OpenRetroPad/OpenRetroPadHW/ATmega32u4/outputs/OpenRetroPad-top.png

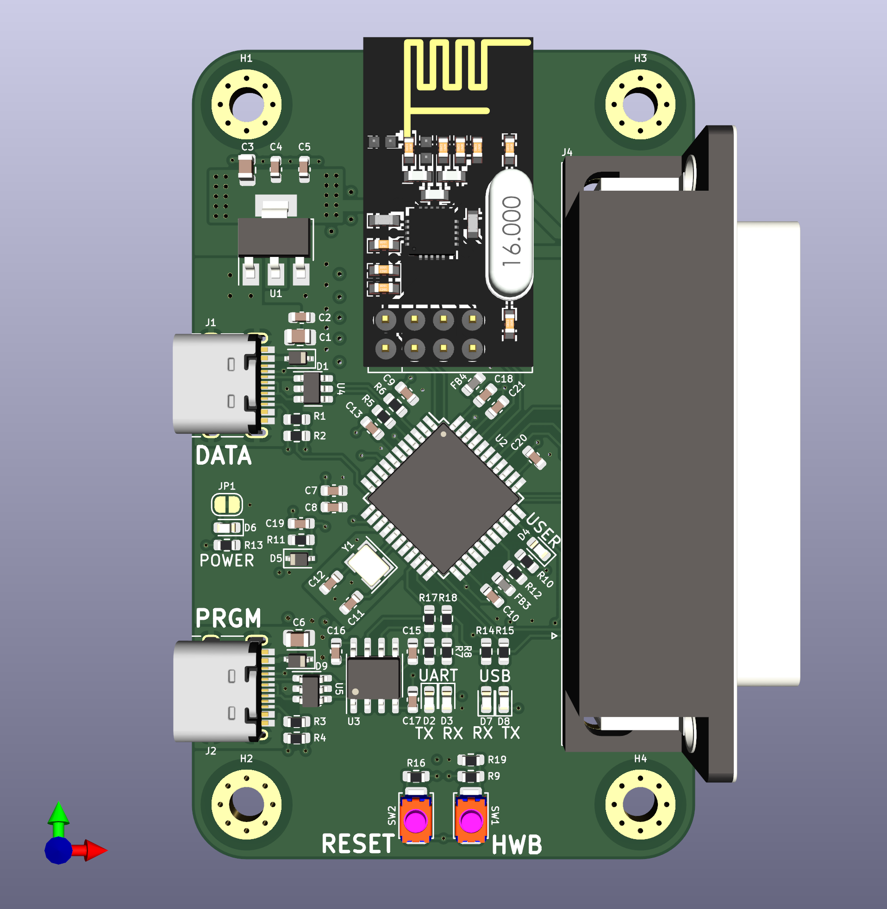
ATmega32u4/outputs/OpenRetroPad-top.png
