OpenRetroPad/OpenRetroPadHW/ATmega32u4/outputs/OpenRetroPad-bottom.png

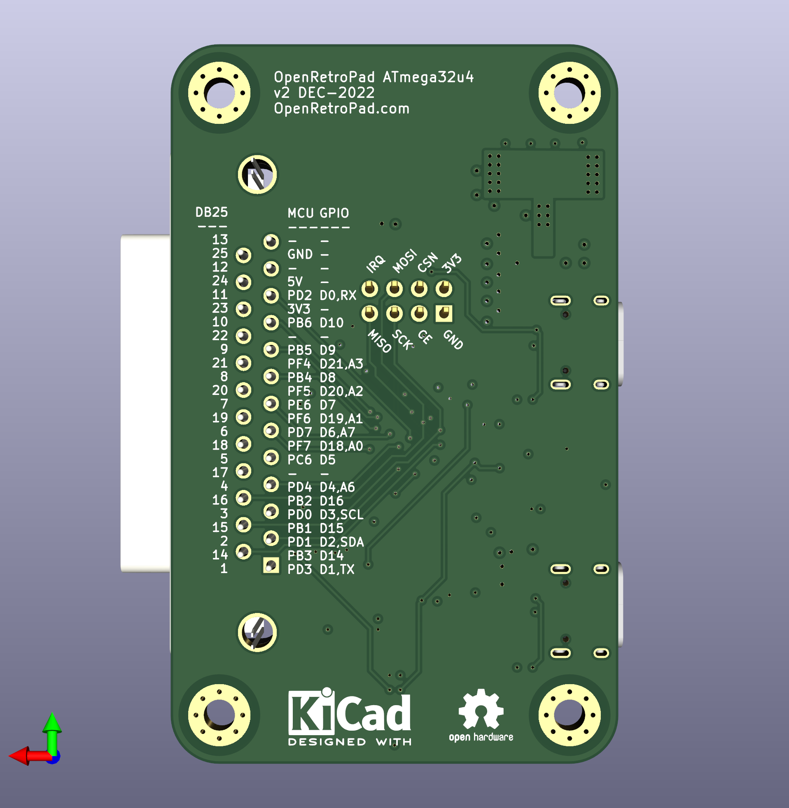
ATmega32u4/outputs/OpenRetroPad-bottom.png
