OpenRetroPad/OpenRetroPadHW/readme.md

OpenRetroPad Hardware
=====================

This repository holds some hardware designs to support [OpenRetroPad](https://github.com/OpenRetroPad/OpenRetroPad) software development. For more information, see specific hardware directories.

* [ATmega32u4](ATmega32u4)
