OpenRetroPad/OpenRetroPadHW/ATmega32u4/outputs/png/OpenRetroPad.pdf-1.png

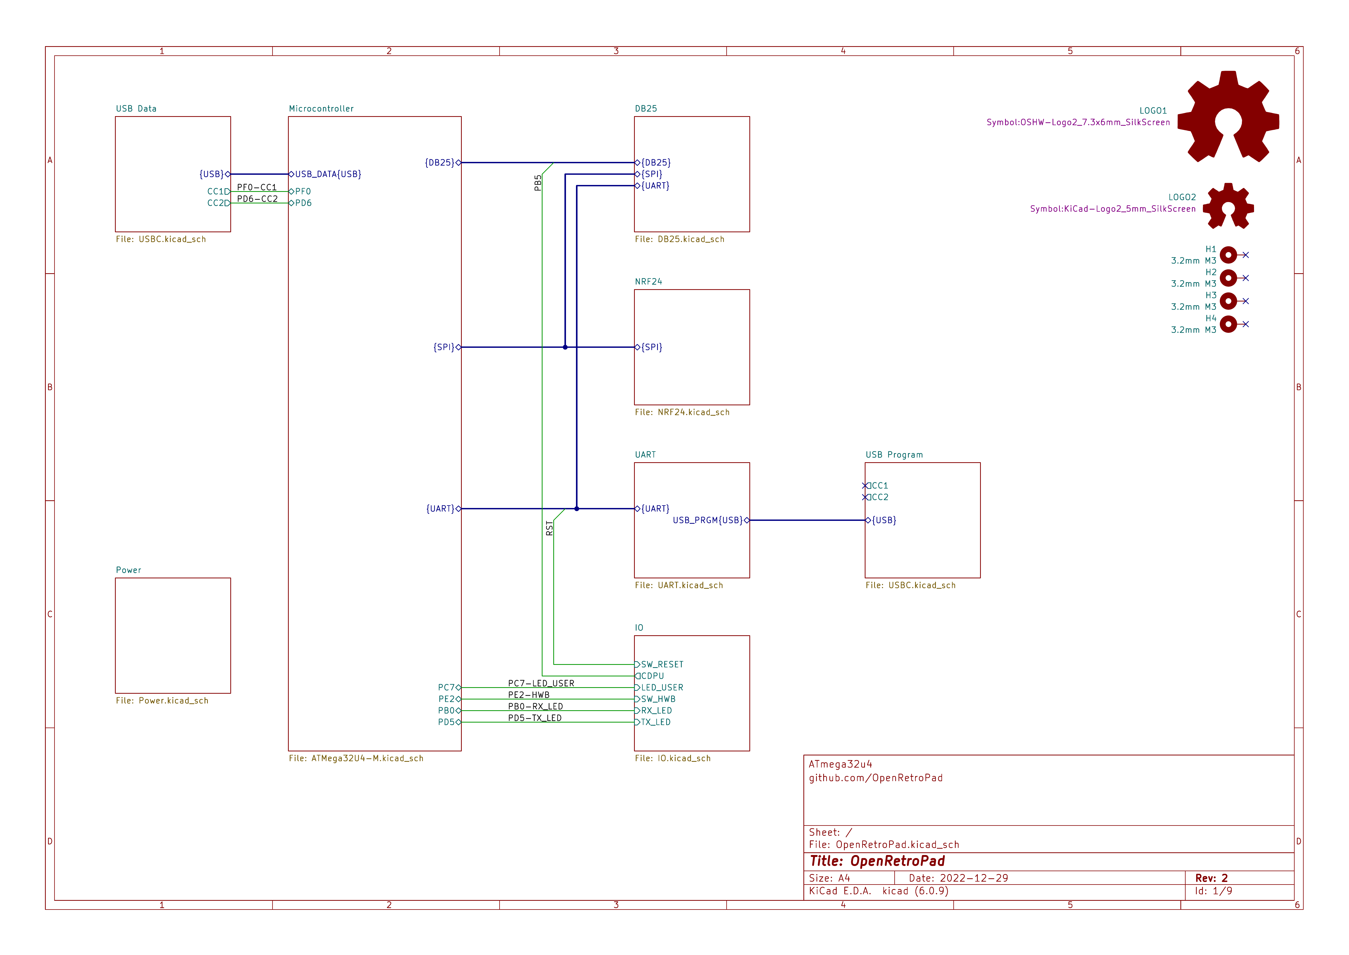
ATmega32u4/outputs/png/OpenRetroPad.pdf-1.png
