OpenRetroPad/OpenRetroPadHW/ATmega32u4/outputs/png/OpenRetroPad.pdf-2.png

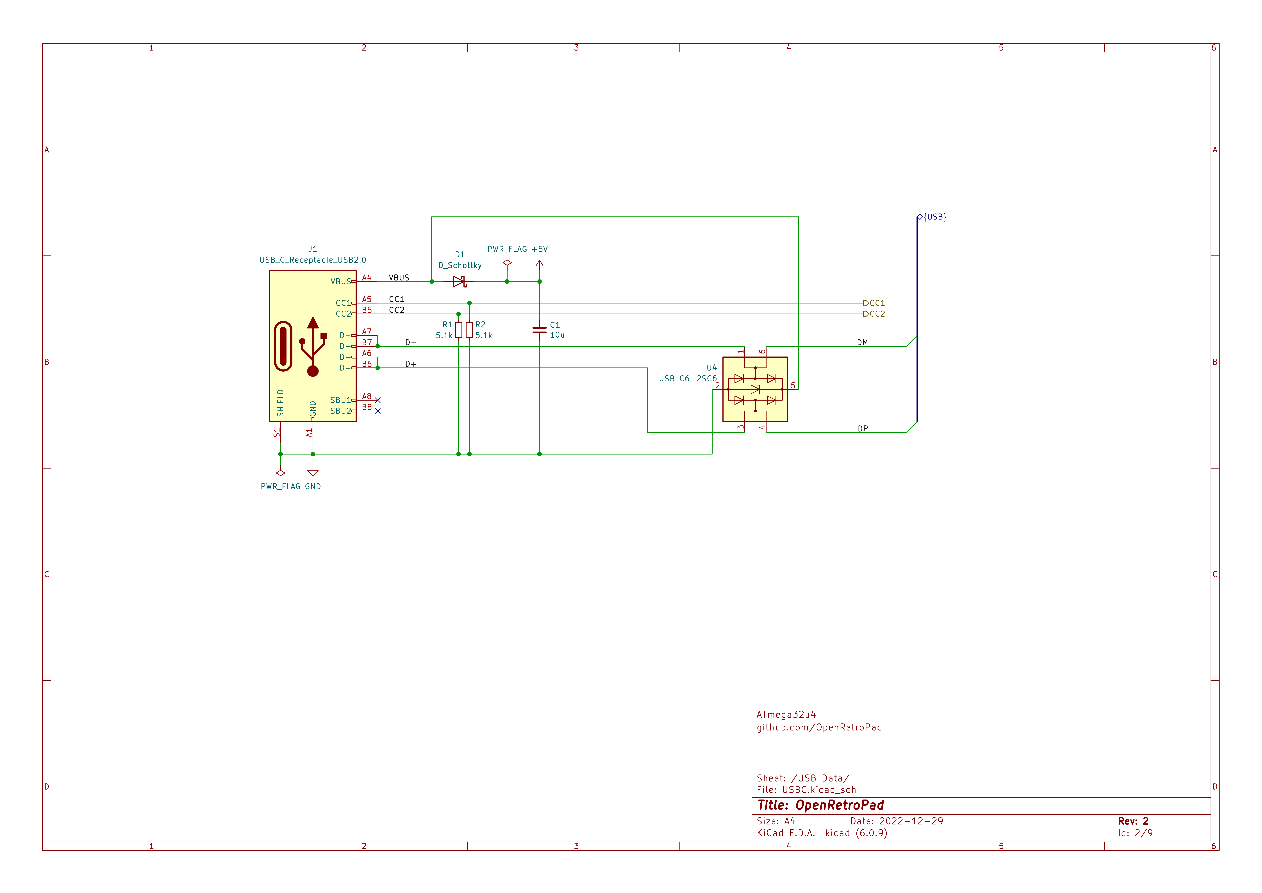
ATmega32u4/outputs/png/OpenRetroPad.pdf-2.png
