OpenRetroPad/OpenRetroPadHW/ATmega32u4/outputs/png/OpenRetroPad.pdf-3.png

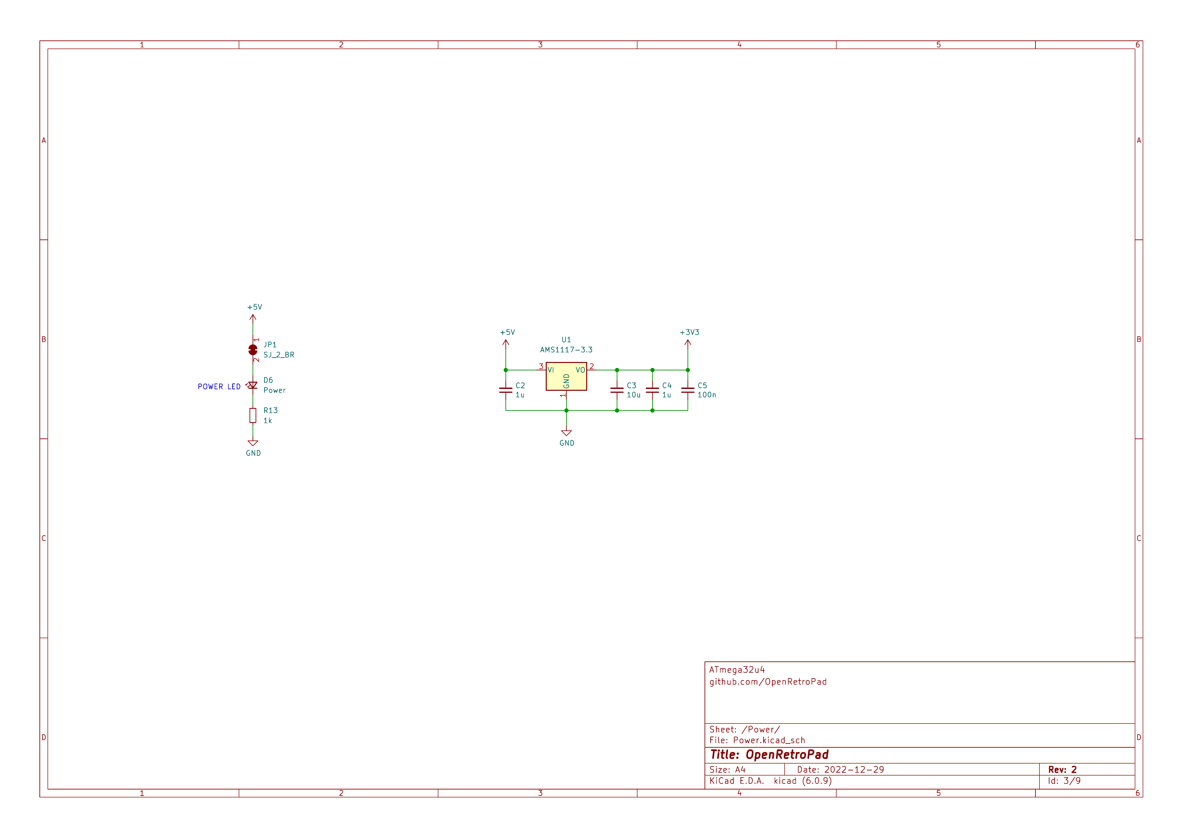
ATmega32u4/outputs/png/OpenRetroPad.pdf-3.png
