OpenRetroPad/OpenRetroPadHW/ATmega32u4/outputs/png/OpenRetroPad.pdf-5.png

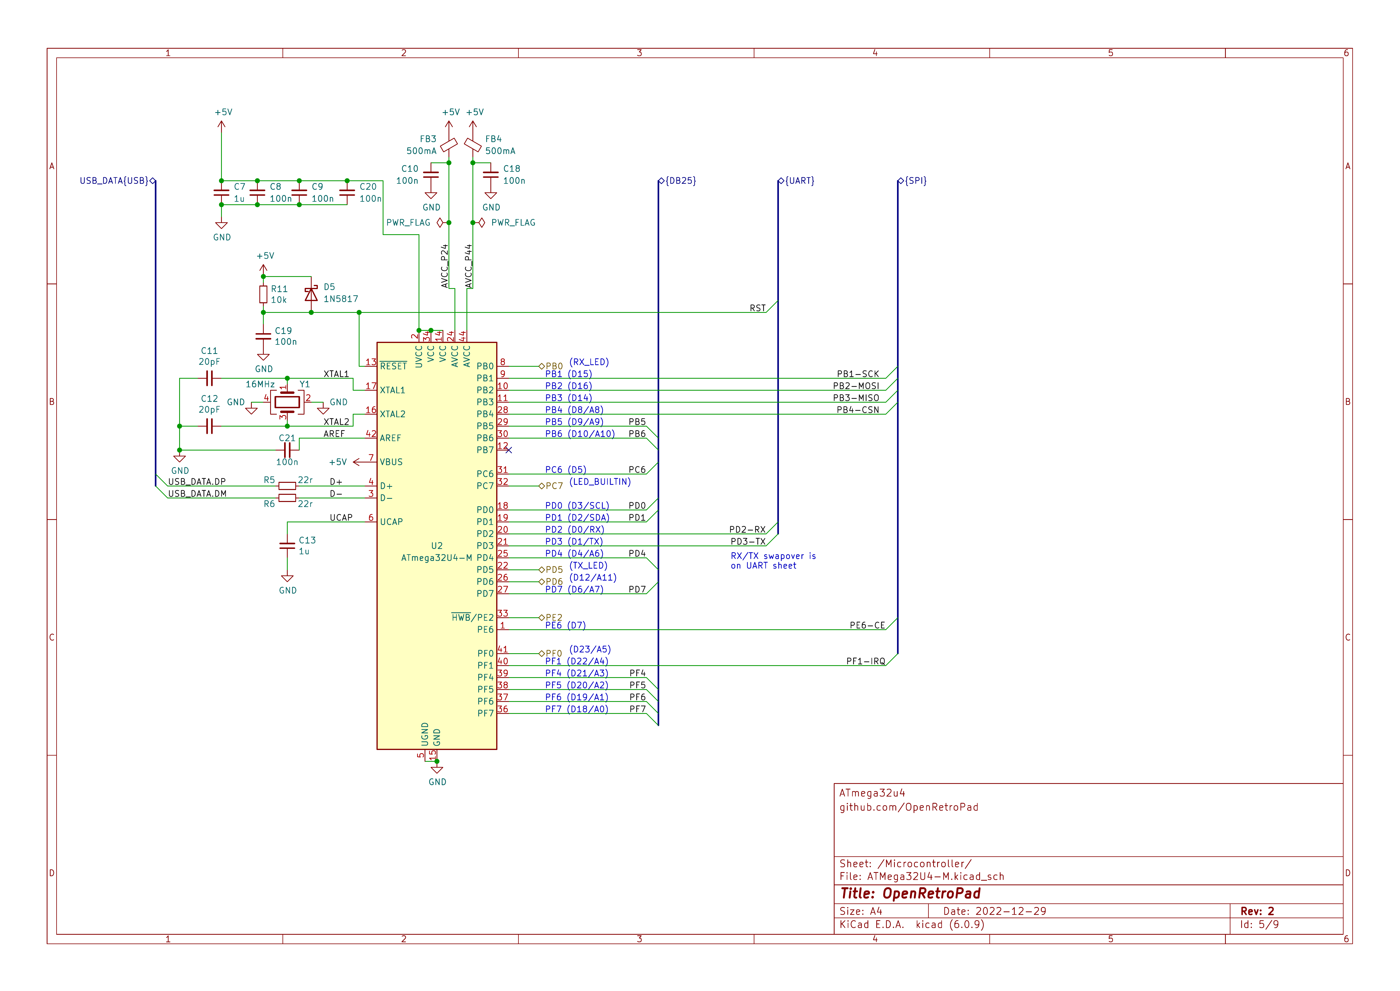
ATmega32u4/outputs/png/OpenRetroPad.pdf-5.png
