OpenRetroPad/OpenRetroPadHW/ATmega32u4/outputs/png/OpenRetroPad.pdf-6.png

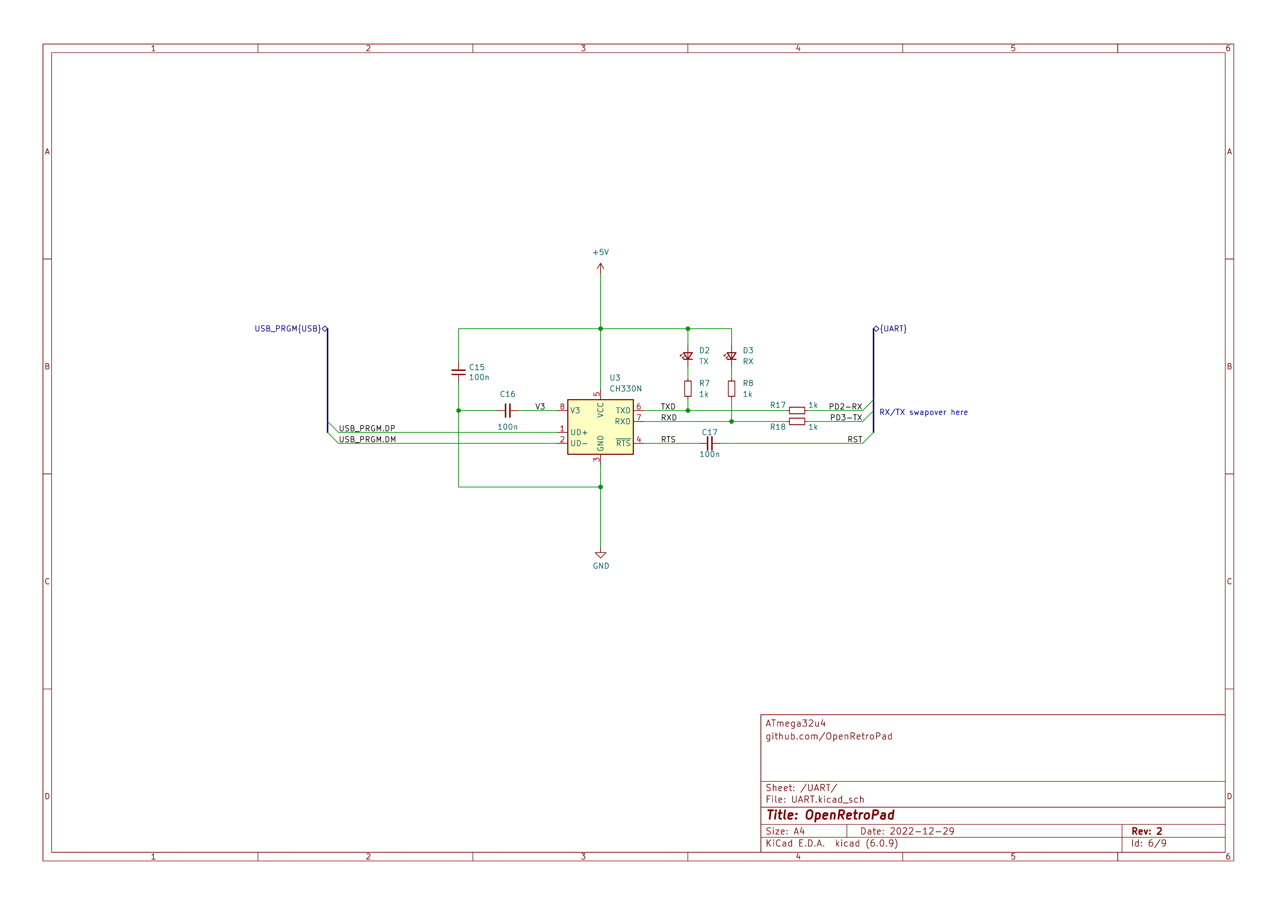
ATmega32u4/outputs/png/OpenRetroPad.pdf-6.png
