OpenRetroPad/OpenRetroPadHW/ATmega32u4/outputs/png/OpenRetroPad.pdf-7.png

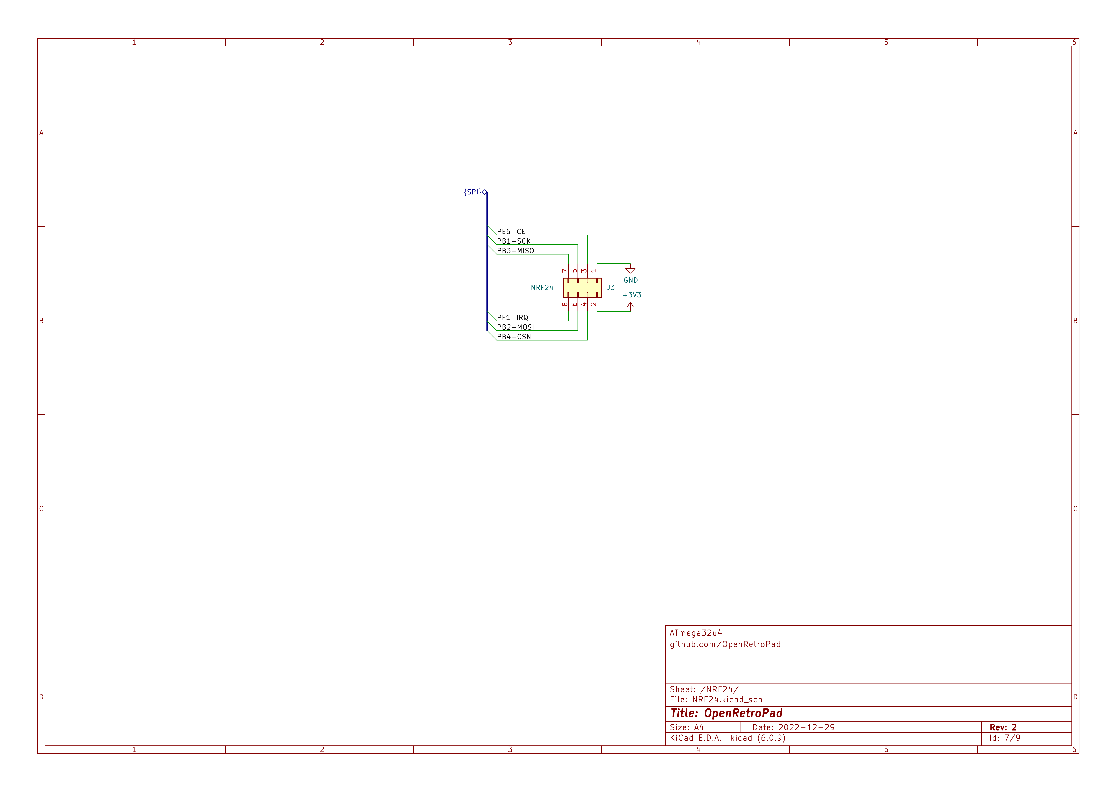
ATmega32u4/outputs/png/OpenRetroPad.pdf-7.png
