OpenRetroPad/OpenRetroPadHW/ATmega32u4/outputs/png/OpenRetroPad.pdf-8.png

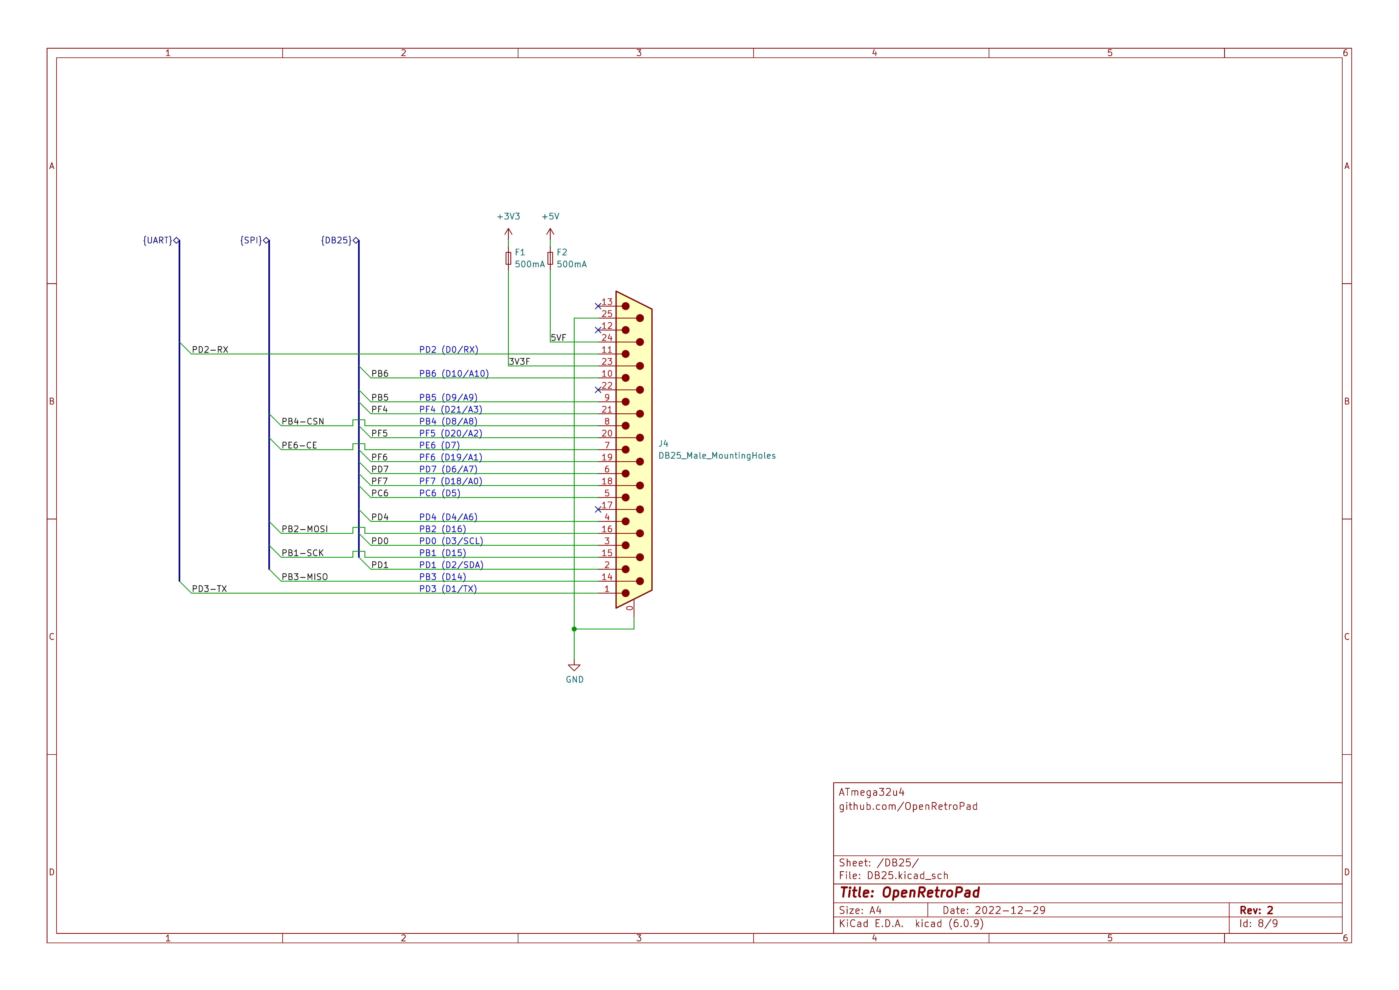
ATmega32u4/outputs/png/OpenRetroPad.pdf-8.png
