OpenRetroPad/OpenRetroPadHW/ATmega32u4/outputs/png/OpenRetroPad.pdf-9.png

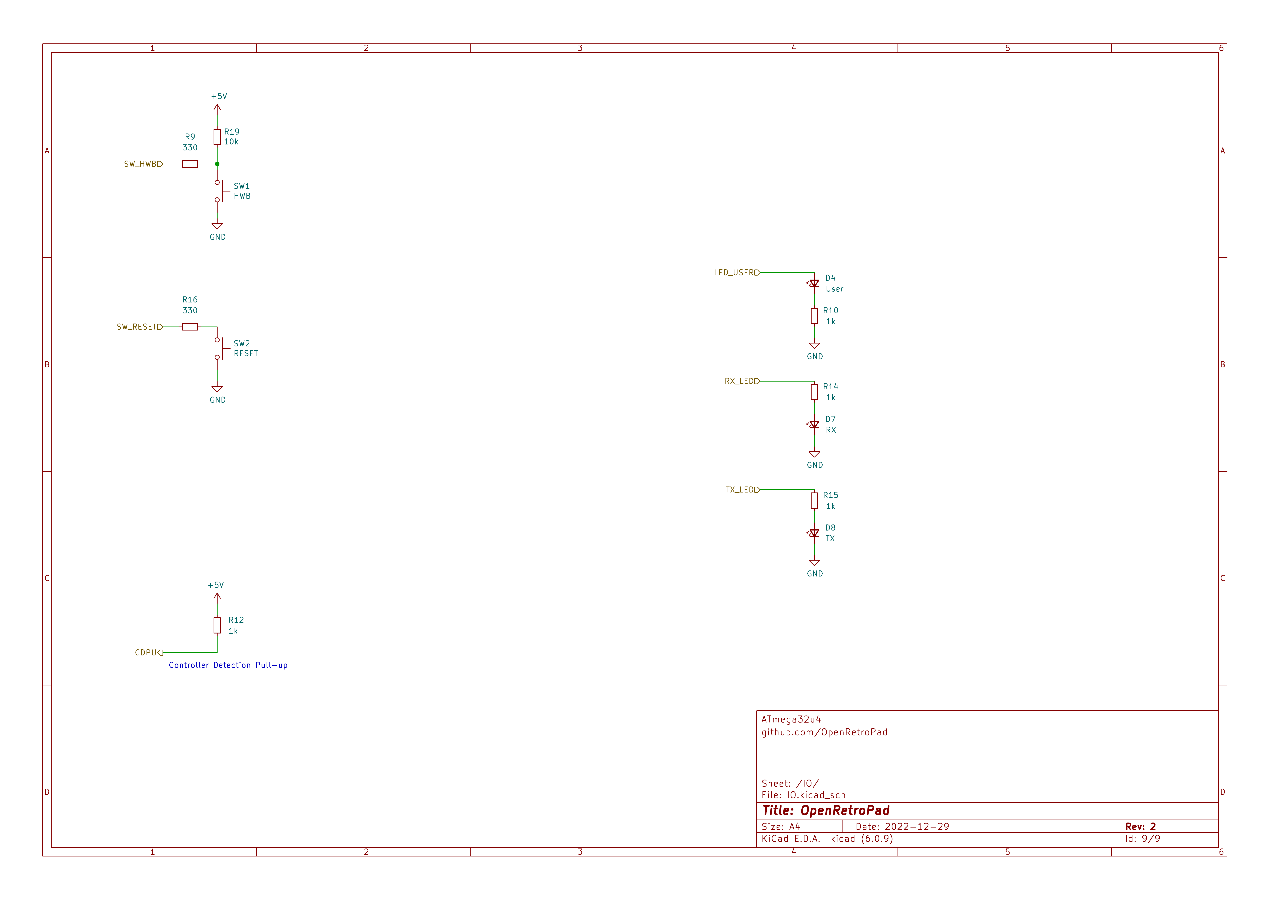
ATmega32u4/outputs/png/OpenRetroPad.pdf-9.png
