OpenRetroPad/OpenRetroPadHW/ATmega32u4/3d/SKRKAE.STEP

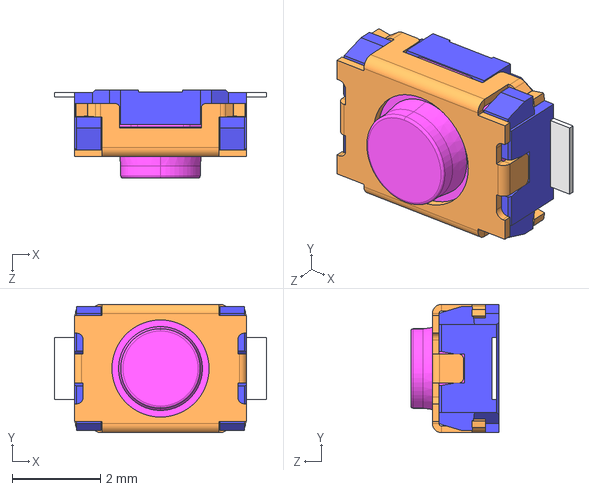
[picture p11: CAD file, 2021-01-03]
ATmega32u4/3d/SKRKAE.STEP
4.80 x 2.90 x 2.00 mm
