OpenRetroPad/OpenRetroPadHW/ATmega32u4/outputs/png/OpenRetroPad-Assembly.pdf-1.png

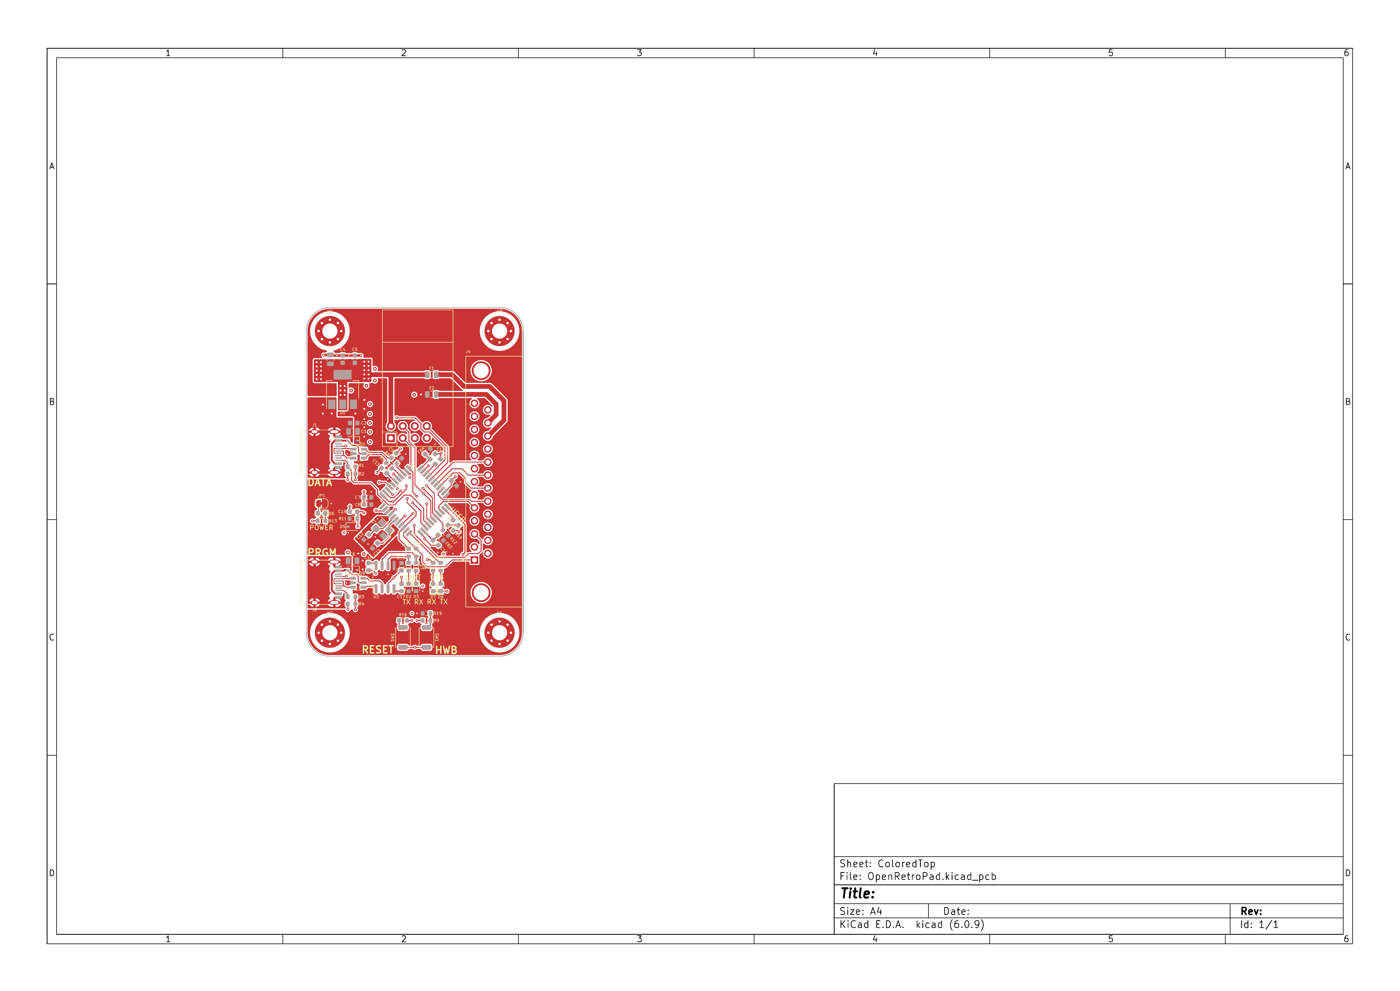
ATmega32u4/outputs/png/OpenRetroPad-Assembly.pdf-1.png
