OpenRetroPad/OpenRetroPadHW/ATmega32u4/outputs/OpenRetroPad-Assembly.pdf

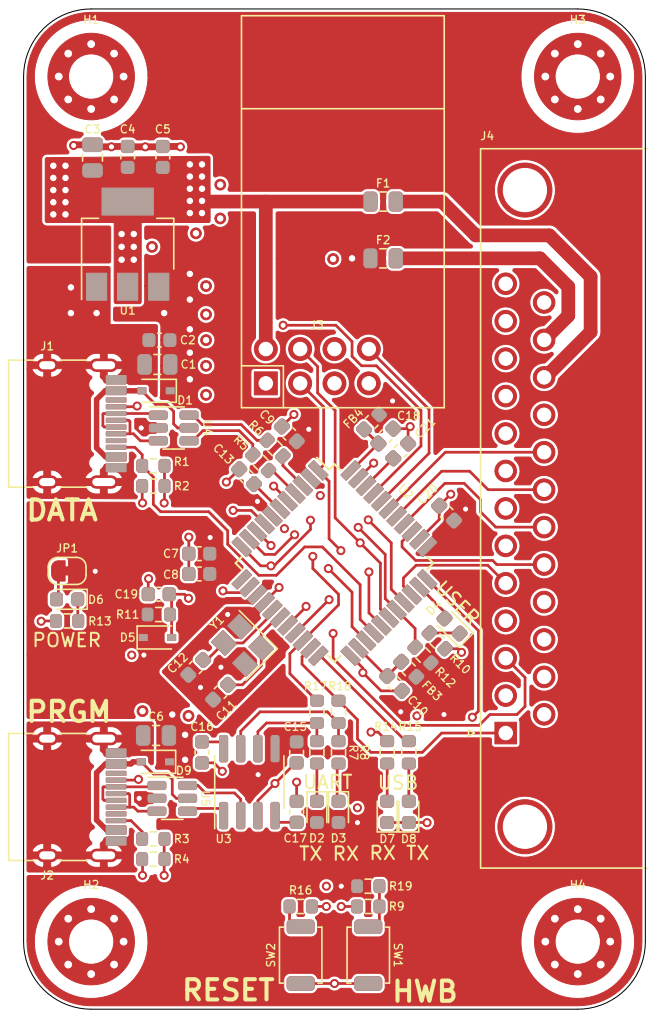
[picture p16: page 1]

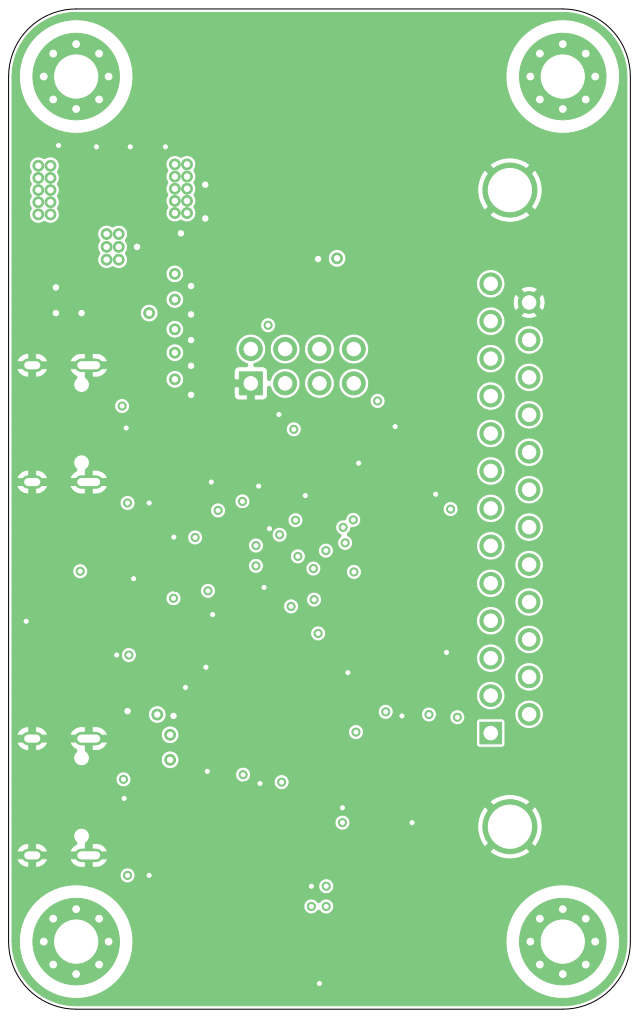
[picture p17: page 2]
D Date: KiCad E.D.A. kicad (6.0.9) Size: A4; Rev:

File: OpenRetroPad.kicad_pcb Sheet: Inner1
Id: 1/1 Title:

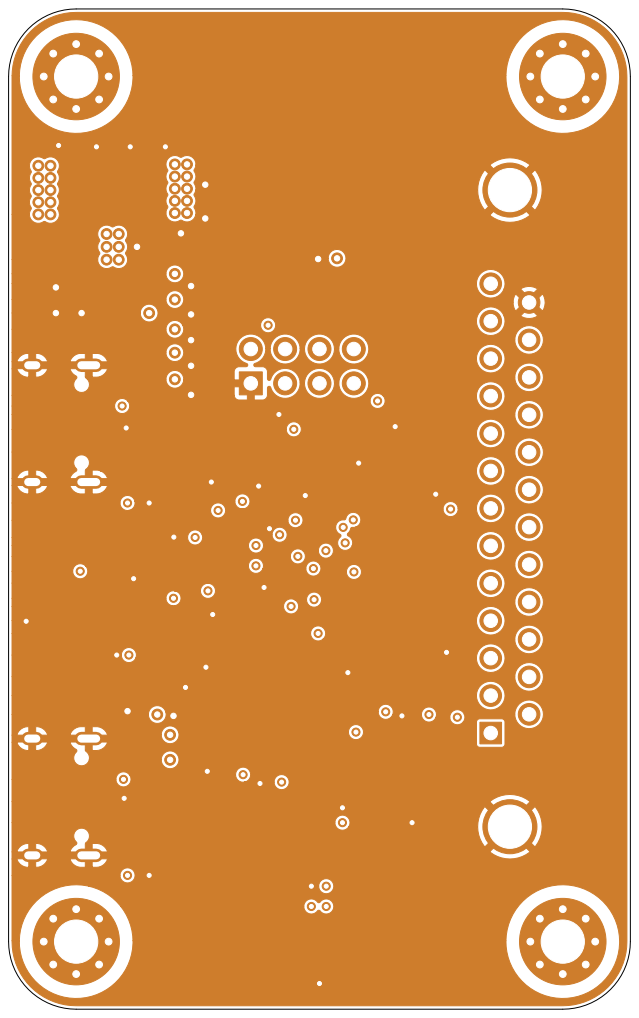
[picture p18: page 3]
D Date: KiCad E.D.A. kicad (6.0.9) Size: A4; Rev:

File: OpenRetroPad.kicad_pcb Sheet: Inner2
Id: 1/1 Title:

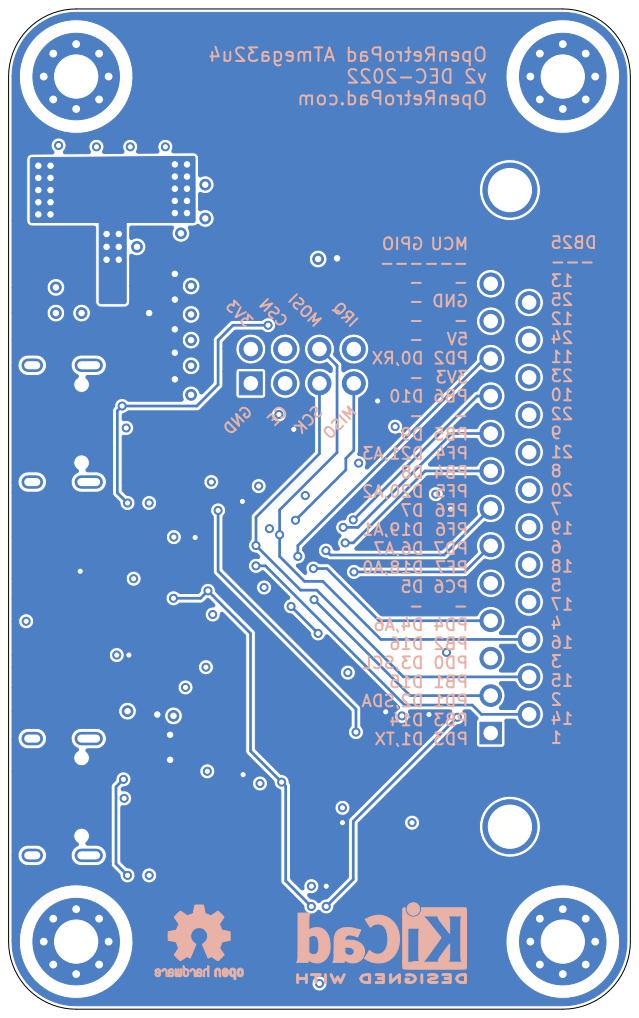
[picture p19: page 4]
141 MCU --- -GND -5V; 3V3 PB6 -PB5 PF4 PB4 PF5 PE6 PF6 PD7 PF7 PC6 -PD4 PB2 PD0 PB1 PD1 PB3 PD3 OpenRetroPad ATmega32u4; Id: 1/1 Title:

D14 D1,TX CSN 1 2 3 4 5 6 1 2 3 4 5 6 ABCD ABCD Date: KiCad E.D.A. kicad (6.0.9) Size: A4 Rev:

v2 DEC-2022 OpenRetroPad.comMOSI GND CE 3V3 GPIO

IRQ SCK MISO DB25

--- ----D0,RX -D10 -D9 D21,A3 D8 D20,A2 D7 D19,A1 D6,A7 D18,A0 D5 -D4,A6 D16 D3,SCL D15 D2,SDA

File: OpenRetroPad.kicad_pcb Sheet: ColoredBottom

36.0000 mm | 47.1000 mm | 64.0000 mm 5.0000 mm ⁵.0000 mm | 13.5000 mm

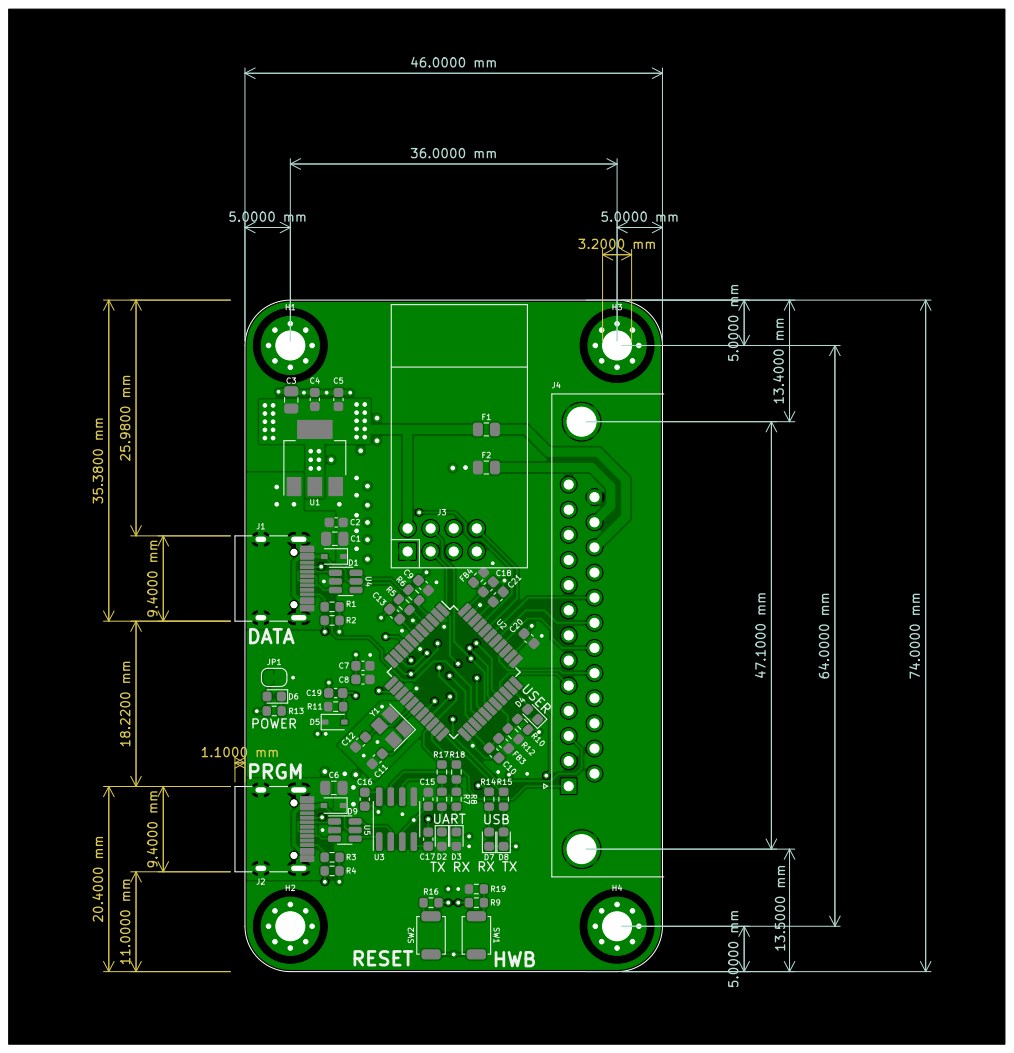
[picture p20: page 5]

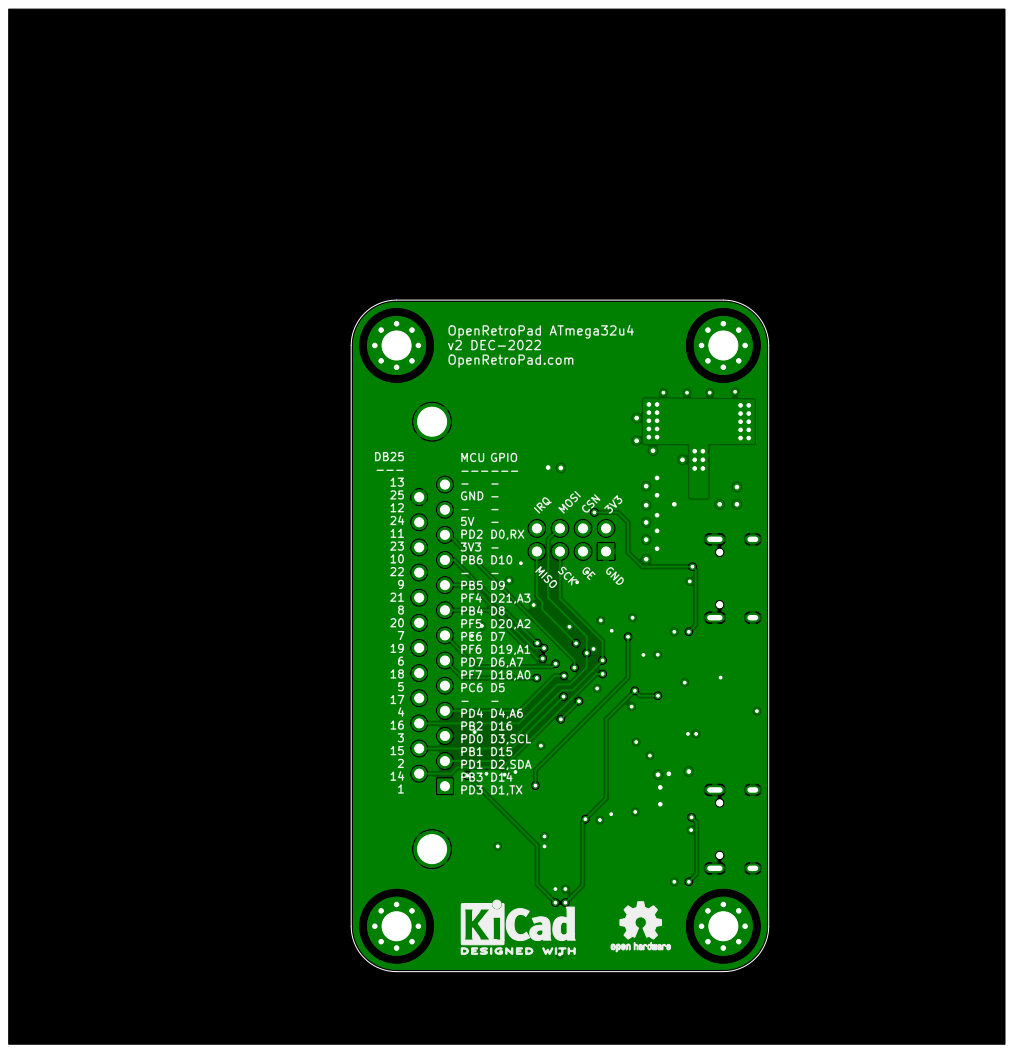
[picture p21: page 6]
6 ABCD; ABCD Date: KiCad E.D.A. kicad (6.0.9) Size: A4; Rev:; Id: 1/1 Title:; File: OpenRetroPad.kicad_pcb; CSN

3V3 PB6 -PB5 PF4 PB4 PF5 PE6 PF6 PD7 PF7 PC6 -PD4 PB2 PD0 PB1 PD1 PB3 PD3 OpenRetroPad ATmega32u4
v2 DEC-2022 OpenRetroPad.comMOSI CE GND 3V3 GPIO
Sheet: ColoredWithBlackBackgroundBottom IRQ MISOSCK DB25
141 MCU
--- -GND -5V

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
