OpenRetroPad/OpenRetroPadHW/ATmega32u4/outputs/OpenRetroPad.pdf

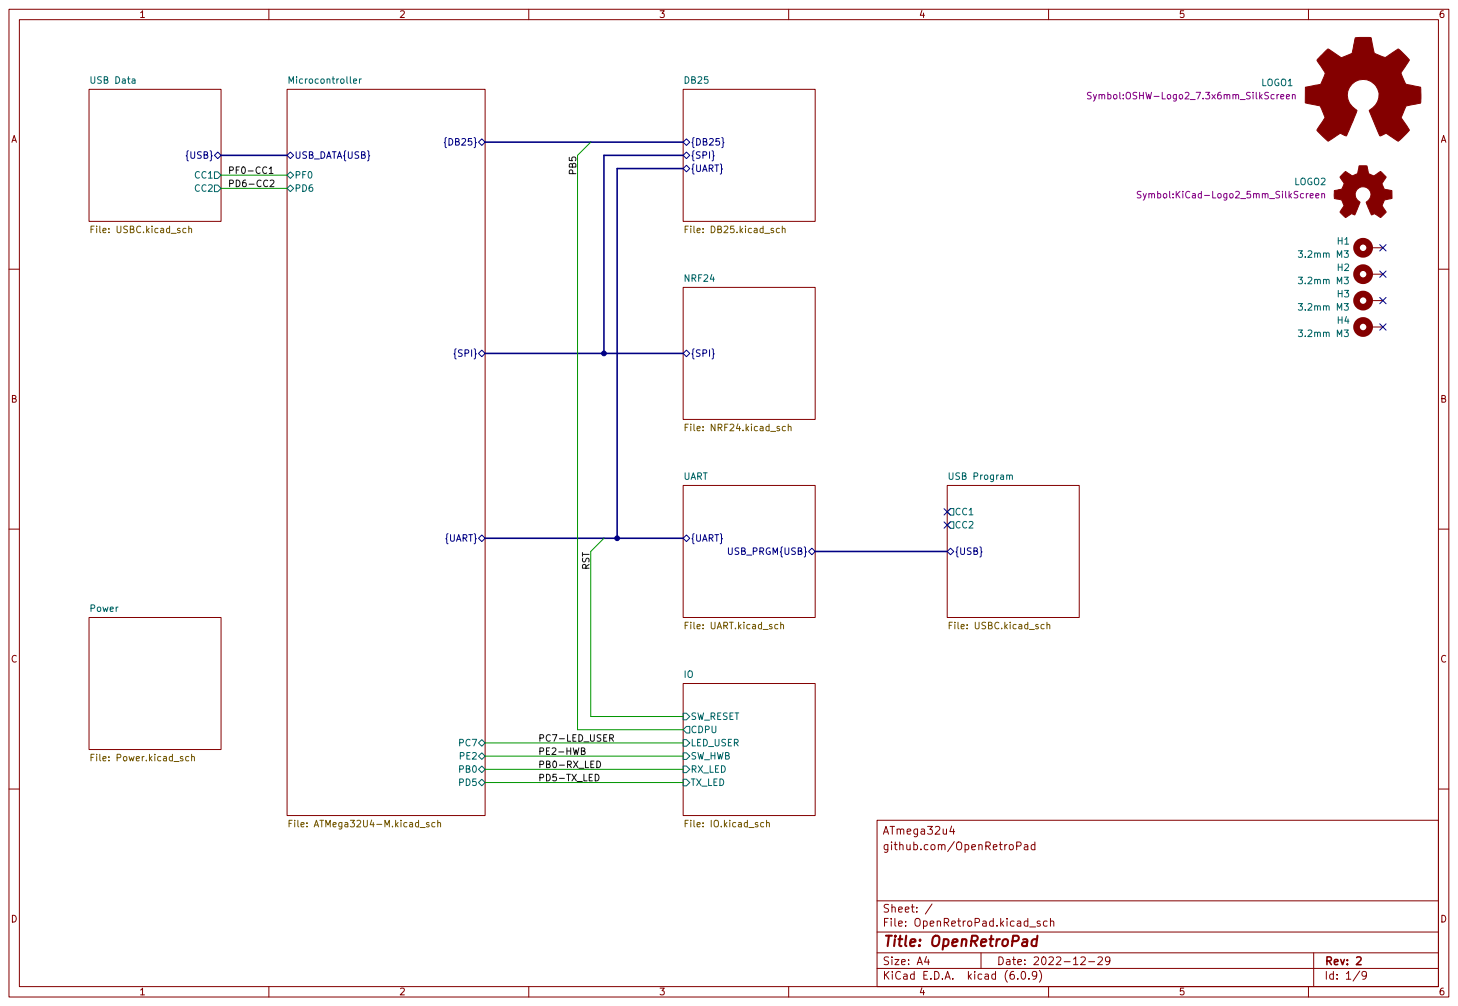
[picture p22: page 1]

{SPI} NRF24 File: NRF24.kicad_sch Power File: Power.kicad_sch

ATmega32u4
File: OpenRetroPad.kicad_sch Sheet: / github.com/OpenRetroPad

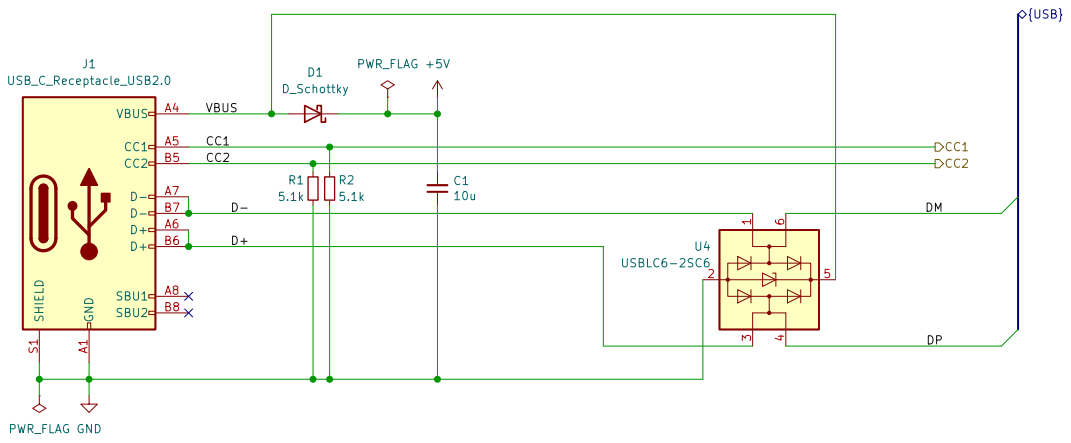
[picture p23: page 2]

ATmega32u4
File: USBC.kicad_sch Sheet: /USB Data/ github.com/OpenRetroPad

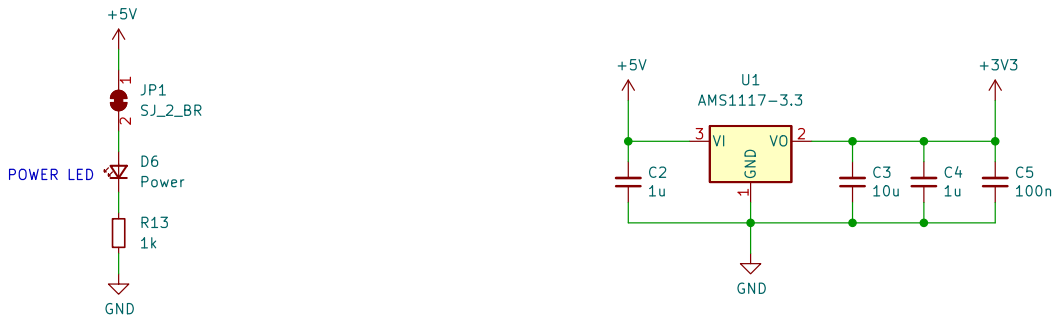
[picture p24: page 3]

File: Power.kicad_sch Sheet: /Power/ github.com/OpenRetroPad

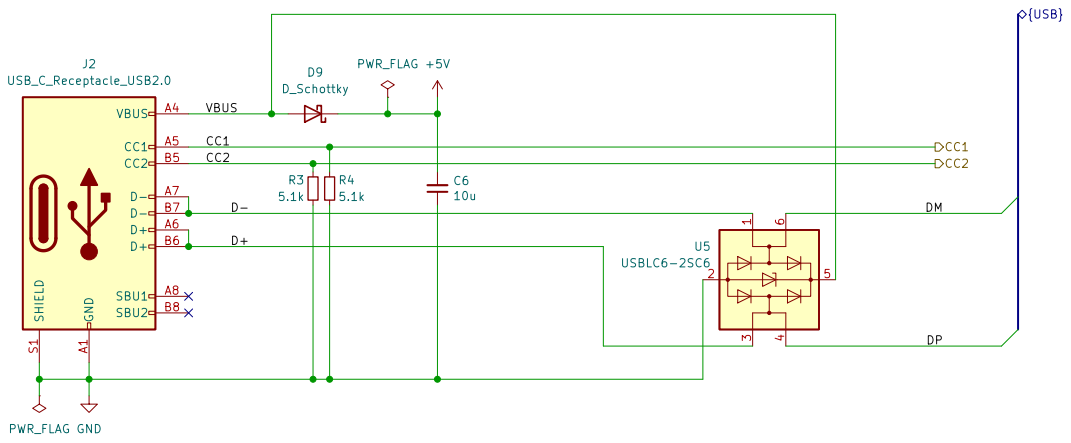
[picture p25: page 4]

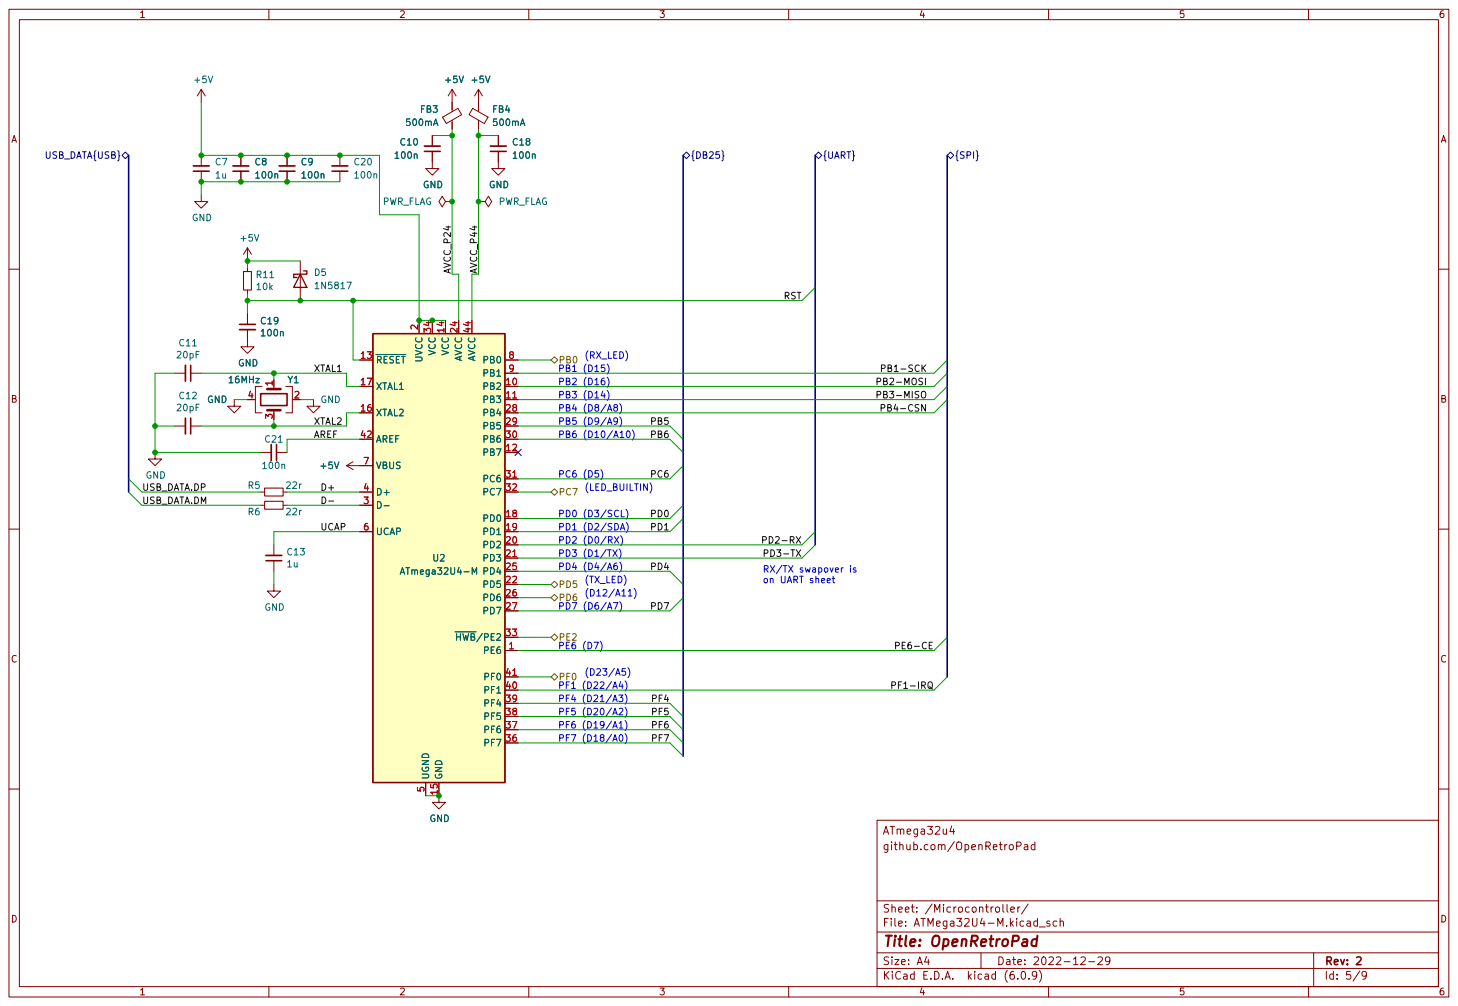
[picture p26: page 5]

2 PD2 20 PD3 21 PD5 22 AVCC 24 PD4 25 PD6 26 PD7 27 PB4 28 PB5 29 D- 3 PB6 30 PC6 31 PC7 32 ~{HWB}/PE233 VCC 34 PF7 36 PF6 37 PF5 38 PF4 39 D+ 4 PF1 40 PF0 41 AREF 42 AVCC 44 UGND

File: ATMega32U4-M.kicad_sch Sheet: /Microcontroller/ github.com/OpenRetroPad

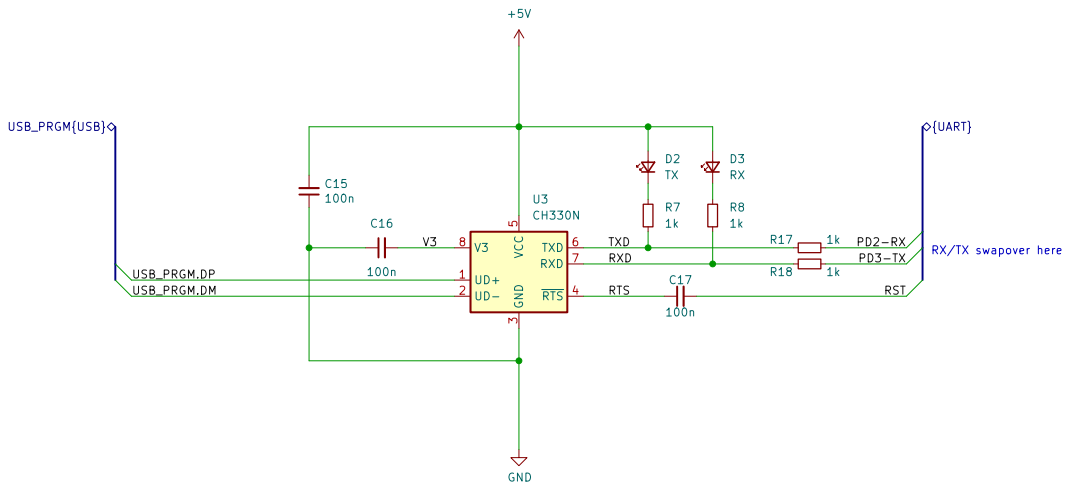
[picture p27: page 6]

File: UART.kicad_sch Sheet: /UART/ github.com/OpenRetroPad

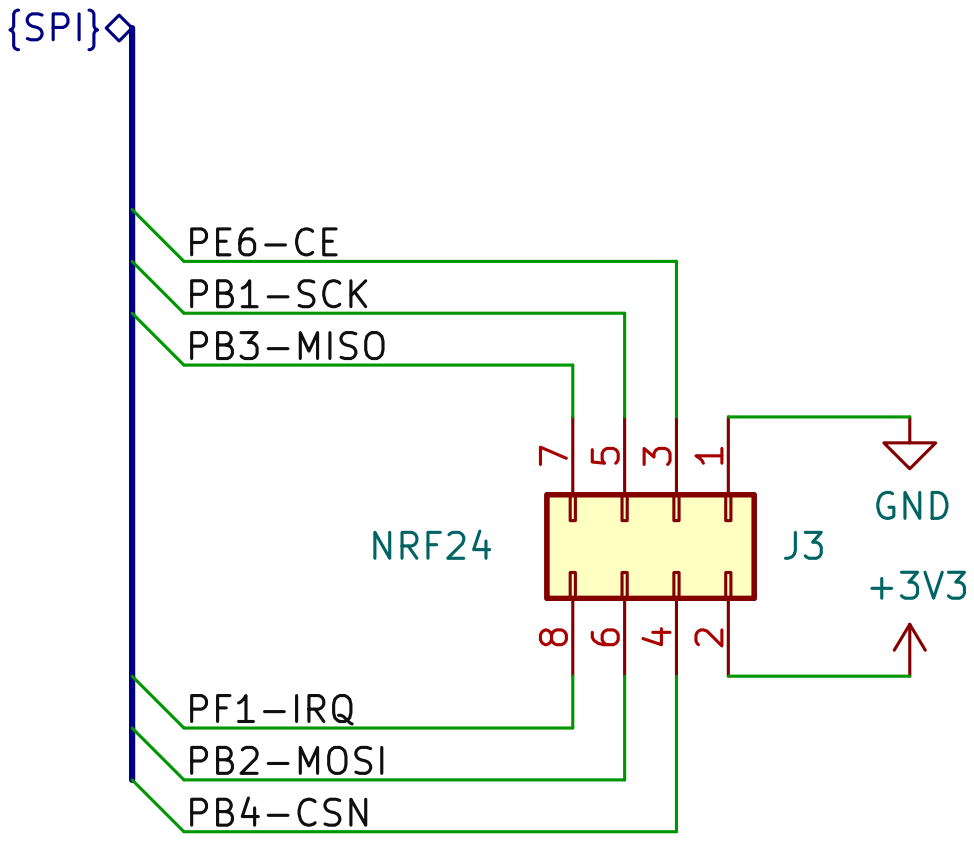
[picture p28: page 7]

File: NRF24.kicad_sch Sheet: /NRF24/ github.com/OpenRetroPad

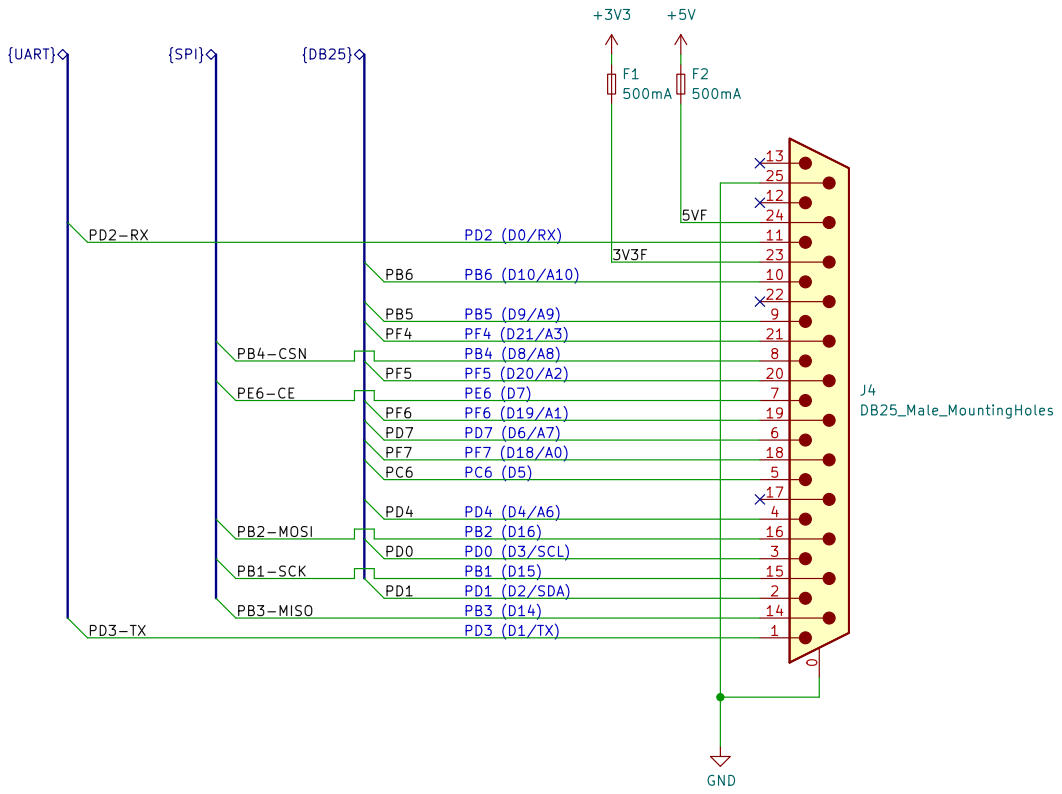
[picture p29: page 8]

ATmega32u4
File: DB25.kicad_sch Sheet: /DB25/ github.com/OpenRetroPad

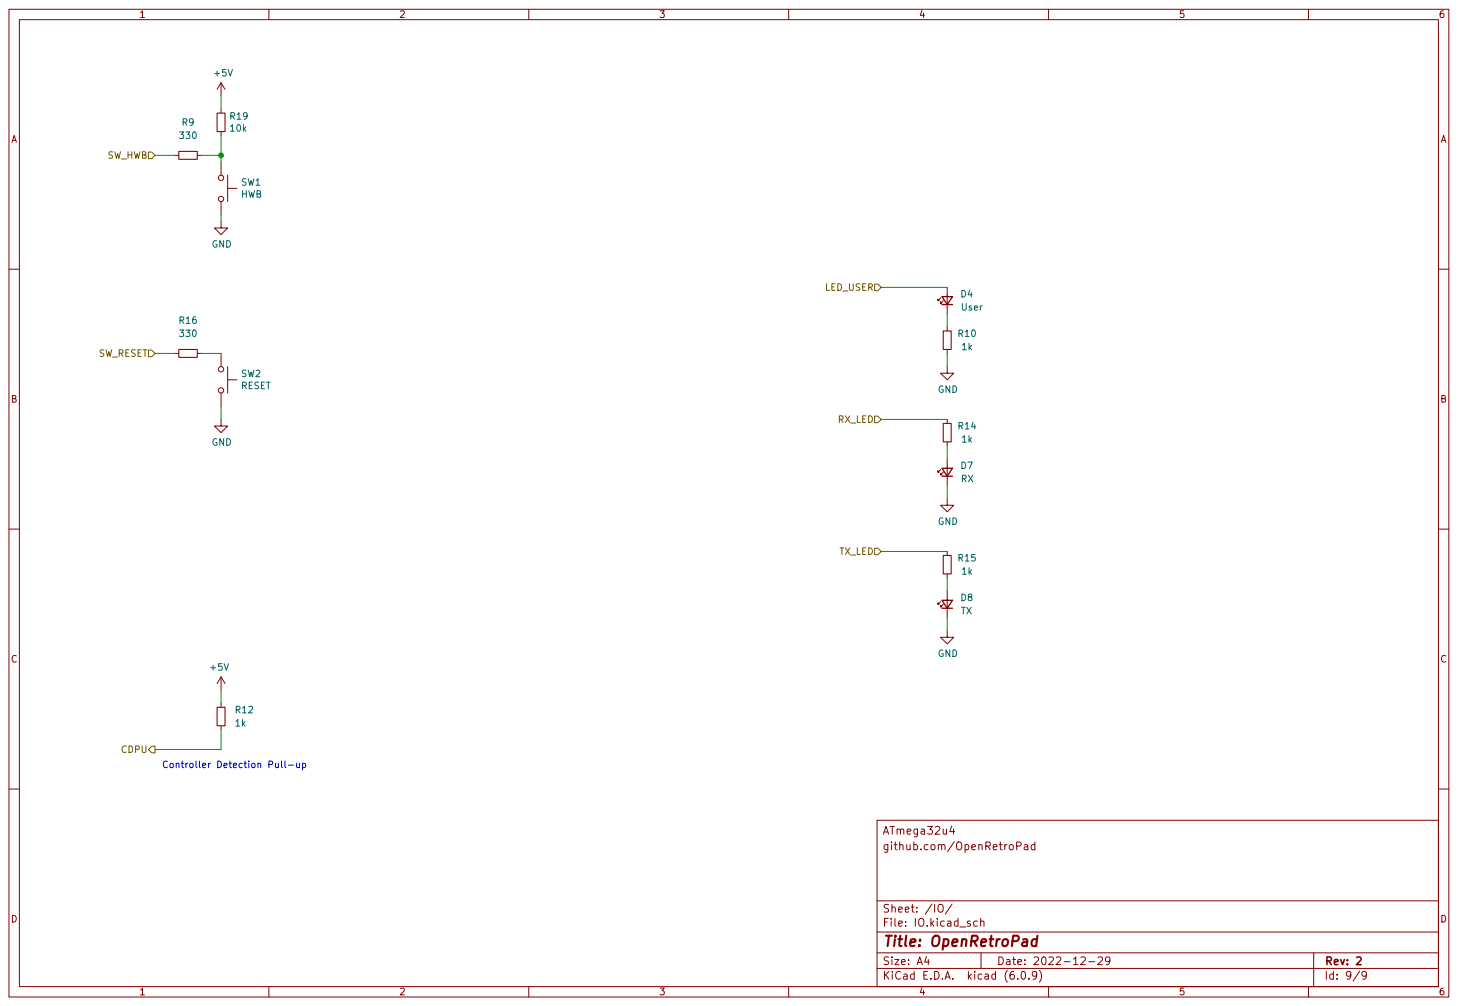
[picture p30: page 9]

ATmega32u4
File: IO.kicad_sch Sheet: /IO/ github.com/OpenRetroPad
