OpenRetroPad/OpenRetroPadHW/ATmega32u4/OpenRetroPad.kicad_pcb

## KiCad design ATmega32u4/OpenRetroPad.kicad_pcb (2023-01-09)

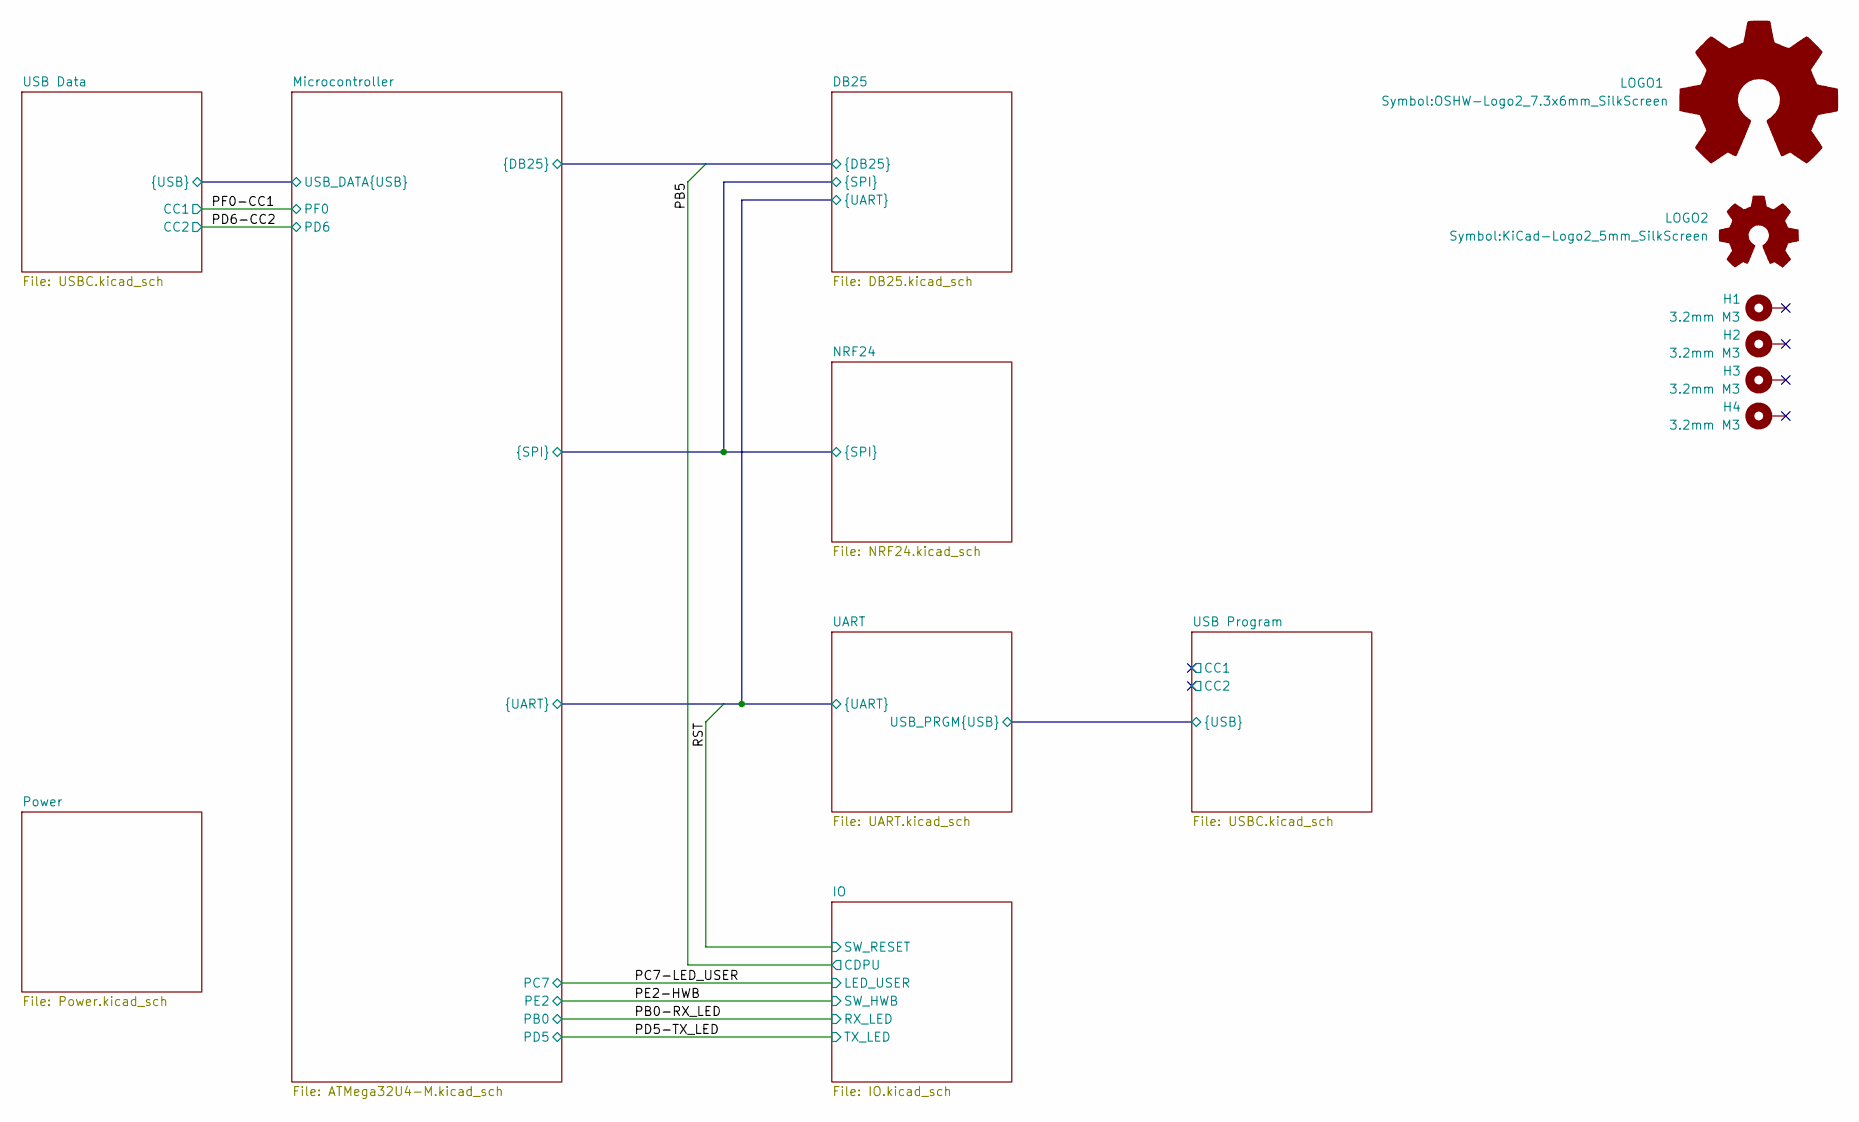
[picture p31: schematic OpenRetroPad.kicad_sch]

Parts:
H1, H2, H3, H4: 3.2mm M3; MountingHole_3.2mm_M3_Pad_Via
LOGO1: Logo_Open_Hardware_Large; OSHW-Logo2_7.3x6mm_SilkScreen
LOGO2: Logo_Open_Hardware_Small; KiCad-Logo2_5mm_SilkScreen

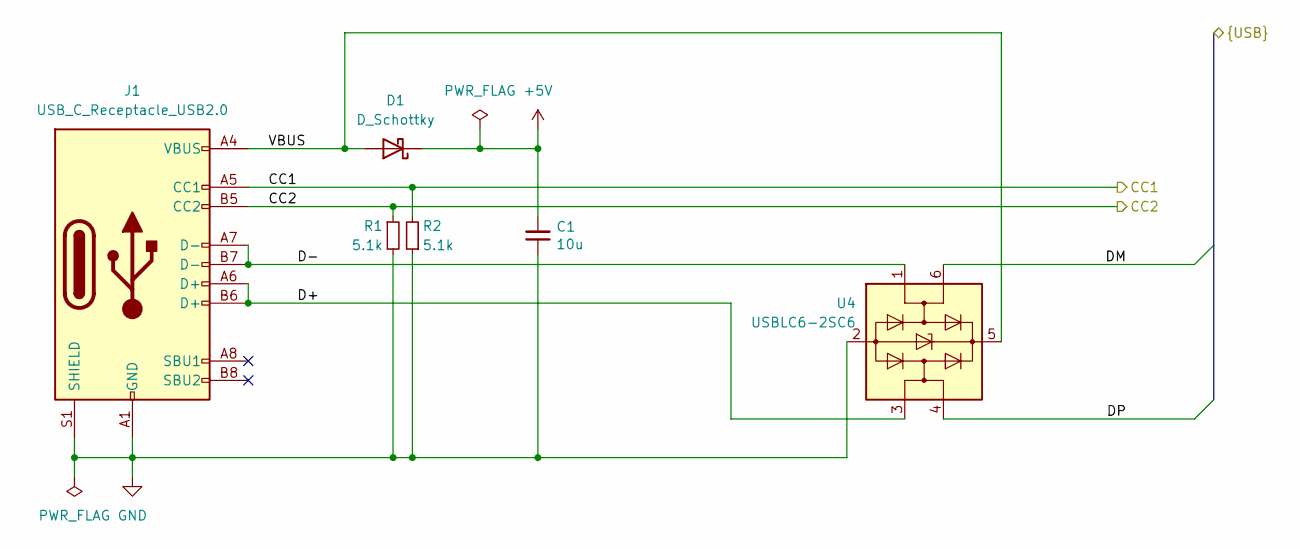
[picture p32: schematic USBC.kicad_sch, OpenRetroPad]

Parts:
C1: 10u; C_0805_2012Metric
D1: D_Schottky; D_SOD-323
J1: USB_C_Receptacle_USB2.0; USB_C_Receptacle_HRO_TYPE-C-31-M-12
R1, R2: 5.1k; R_0603_1608Metric
U4: USBLC6-2SC6; SOT-23-6

Connections:
+5V: C1.2, D1.1 (K); also elsewhere on the board
/Microcontroller/USB_DATA.DM: U4.6 (I/O1); also elsewhere on the board
/Microcontroller/USB_DATA.DP: U4.4 (I/O2); also elsewhere on the board
/PD6-CC2: J1.B5 (CC2), R1.1; also elsewhere on the board
/PF0-CC1: J1.A5 (CC1), R2.2; also elsewhere on the board
/USB Data/D+: J1.A6 (D+), J1.B6 (D+), U4.3 (I/O2)
/USB Data/D-: J1.A7 (D-), J1.B7 (D-), U4.1 (I/O1)
/USB Data/VBUS: D1.2 (A), J1.A4 (VBUS), J1.A9 (VBUS), J1.B4 (VBUS), J1.B9 (VBUS), U4.5 (VBUS)
GND: C1.1, J1.A1 (GND), J1.A12 (GND), J1.B1 (GND), J1.B12 (GND), J1.S1 (SHIELD), R1.2, R2.1, U4.2 (GND); also elsewhere on the board

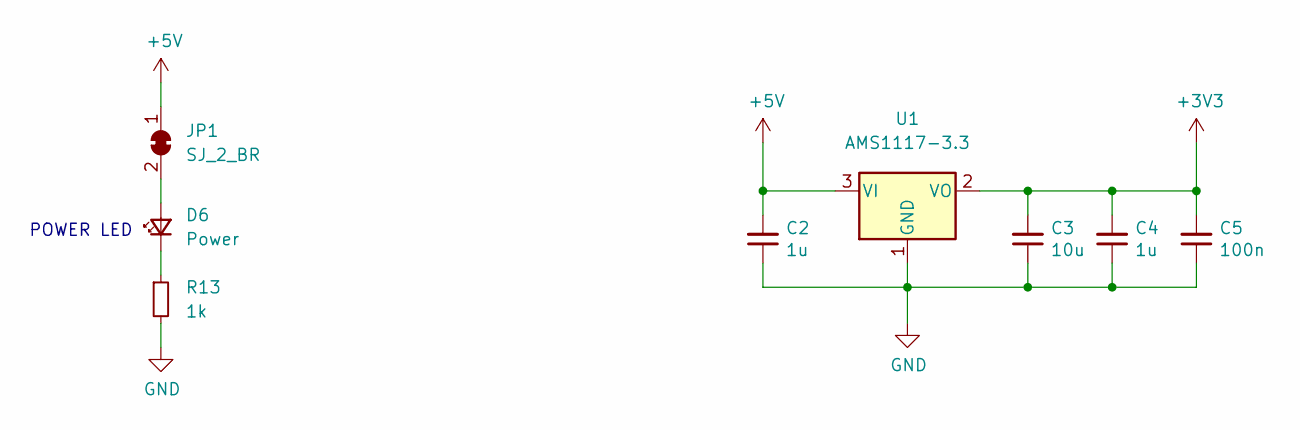
[picture p33: schematic Power.kicad_sch, OpenRetroPad]

Parts:
C2, C4: 1u; C_0603_1608Metric
C3: 10u; C_0805_2012Metric
C5: 100n; C_0603_1608Metric
D6: Power; LED_0603_1608Metric
JP1: SJ_2_BR; SolderJumper-2_P1.3mm_Bridged_RoundedPad1.0x1.5mm
R13: 1k; R_0603_1608Metric
U1: AMS1117-3.3; SOT-223-3_TabPin2

Connections:
+3V3: C3.2, C4.2, C5.2, U1.2 (VO); also elsewhere on the board
+5V: C2.2, JP1.1 (A), U1.3 (VI); also elsewhere on the board
GND: C2.1, C3.1, C4.1, C5.1, R13.2, U1.1 (GND); also elsewhere on the board
unnamed: D6.1 (K), R13.1
unnamed: D6.2 (A), JP1.2 (B)

Notes on the sheet:
POWER LED

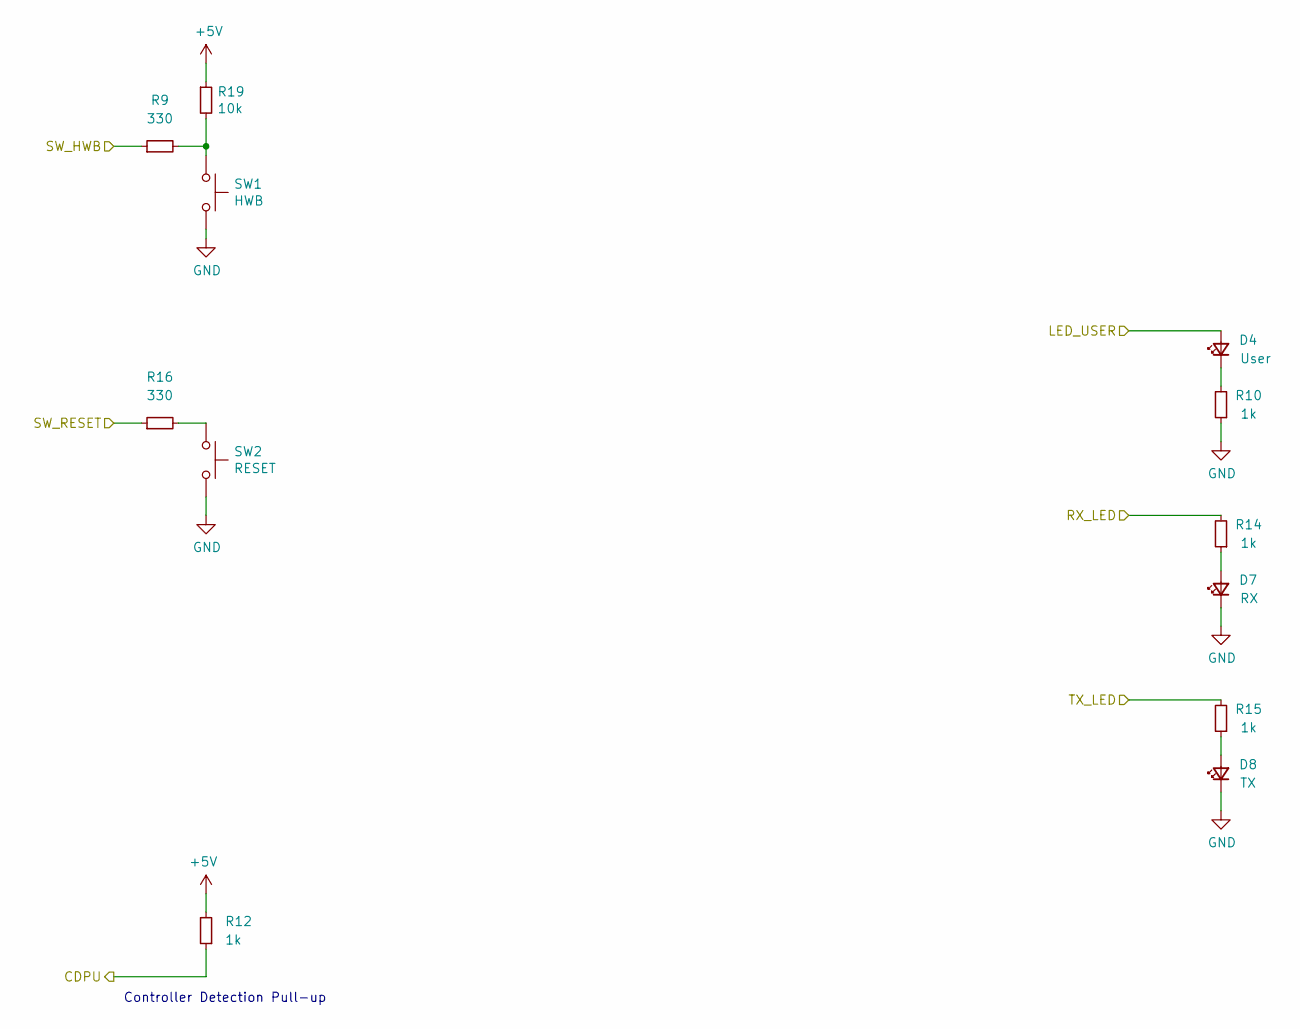
[picture p34: schematic IO.kicad_sch, OpenRetroPad]

Parts:
D4: User; LED_0603_1608Metric
D7: RX; LED_0603_1608Metric
D8: TX; LED_0603_1608Metric
R9, R16: 330; R_0603_1608Metric
R10, R12, R14, R15: 1k; R_0603_1608Metric
R19: 10k; R_0603_1608Metric
SW1: HWB; Alps_SKRK
SW2: RESET; Alps_SKRK

Connections:
+5V: R12.2, R19.1; also elsewhere on the board
/DB25/PB5: R12.1; also elsewhere on the board
/DB25/RST: R16.1; also elsewhere on the board
/PB0-RX_LED: R14.2; also elsewhere on the board
/PC7-LED_USER: D4.2 (A); also elsewhere on the board
/PD5-TX_LED: R15.2; also elsewhere on the board
/PE2-HWB: R9.1; also elsewhere on the board
GND: D7.1 (K), D8.1 (K), R10.1, SW1.2, SW2.2; also elsewhere on the board
unnamed: D4.1 (K), R10.2
unnamed: D7.2 (A), R14.1
unnamed: D8.2 (A), R15.1
unnamed: R16.2, SW2.1
unnamed: R9.2, R19.2, SW1.1

Notes on the sheet:
Controller Detection Pull-up

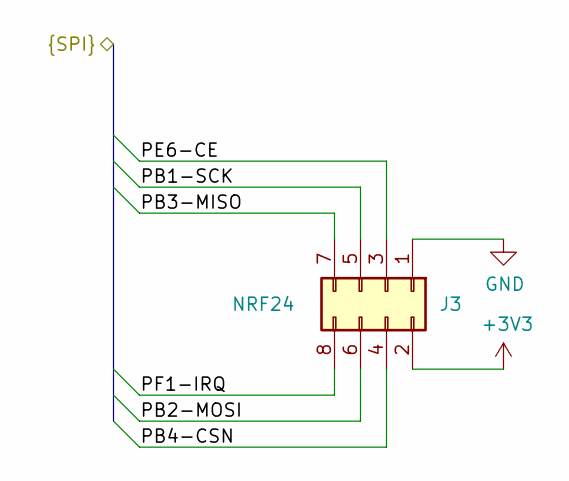
[picture p35: schematic NRF24.kicad_sch, OpenRetroPad]

Parts:
J3: NRF24; NRF24L01

Connections:
+3V3: J3.2; also elsewhere on the board
/DB25/PB1-SCK: J3.5; also elsewhere on the board
/DB25/PB2-MOSI: J3.6; also elsewhere on the board
/DB25/PB3-MISO: J3.7; also elsewhere on the board
/DB25/PB4-CSN: J3.4; also elsewhere on the board
/DB25/PE6-CE: J3.3; also elsewhere on the board
/DB25/PF1-IRQ: J3.8; also elsewhere on the board
GND: J3.1; also elsewhere on the board

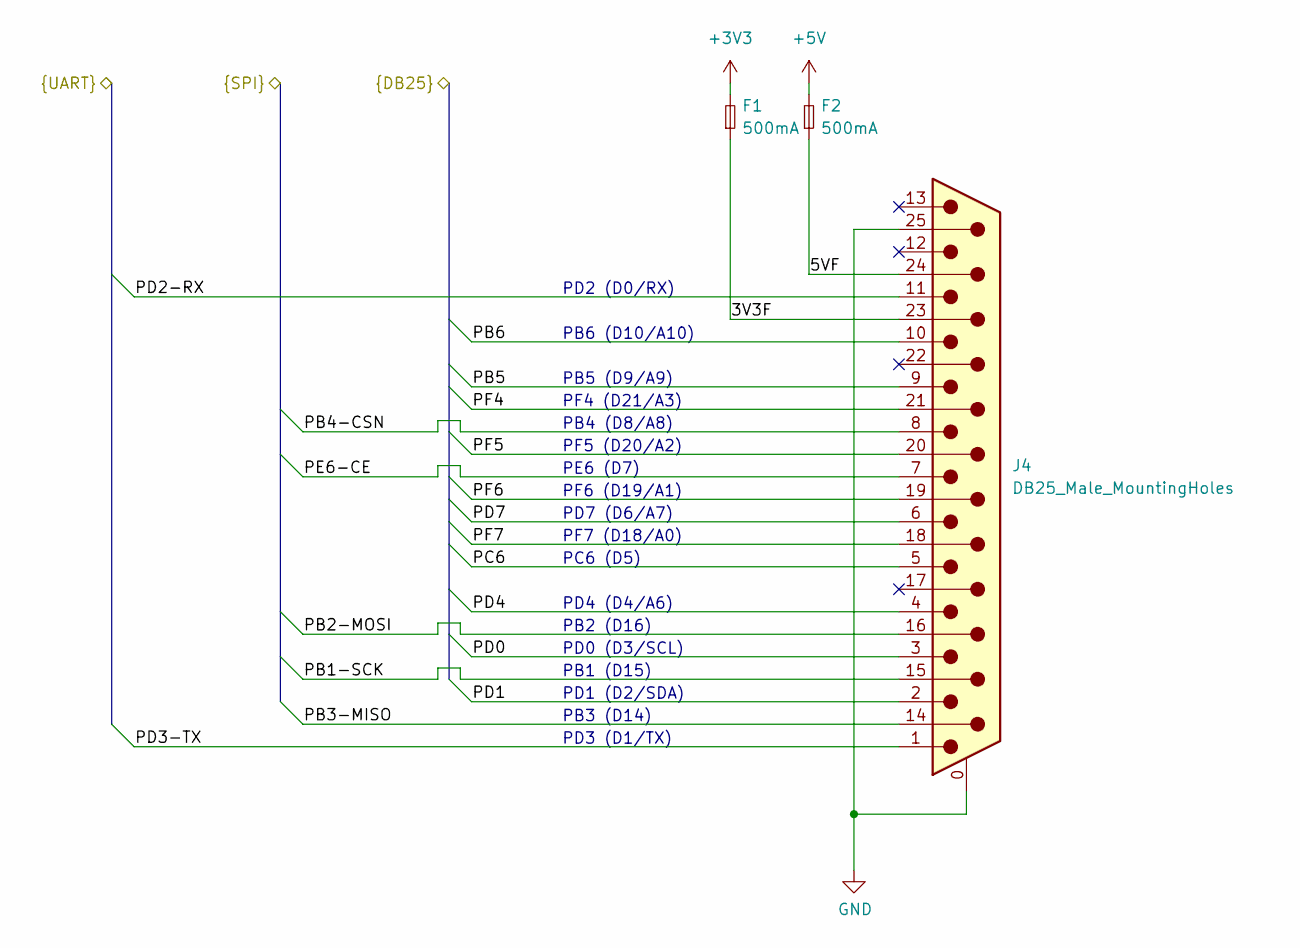
[picture p36: schematic DB25.kicad_sch, OpenRetroPad]

Parts:
F1, F2: 500mA; Fuse_0805_2012Metric
J4: DB25_Male_MountingHoles; DSUB-25_Male_Horizontal_P2.77x2.84mm_EdgePinOffset7.70mm_Ho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

Connections:
+3V3: F1.2; also elsewhere on the board
+5V: F2.2; also elsewhere on the board
/DB25/3V3F: F1.1, J4.23
/DB25/5VF: F2.1, J4.24
/DB25/PB1-SCK: J4.15; also elsewhere on the board
/DB25/PB2-MOSI: J4.16; also elsewhere on the board
/DB25/PB3-MISO: J4.14; also elsewhere on the board
/DB25/PB4-CSN: J4.8; also elsewhere on the board
/DB25/PB5: J4.9; also elsewhere on the board
/DB25/PB6: J4.10; also elsewhere on the board
/DB25/PC6: J4.5; also elsewhere on the board
/DB25/PD0: J4.3; also elsewhere on the board
/DB25/PD1: J4.2; also elsewhere on the board
/DB25/PD2-RX: J4.11; also elsewhere on the board
/DB25/PD3-TX: J4.1; also elsewhere on the board
/DB25/PD4: J4.4; also elsewhere on the board
/DB25/PD7: J4.6; also elsewhere on the board
/DB25/PE6-CE: J4.7; also elsewhere on the board
/DB25/PF4: J4.21; also elsewhere on the board
/DB25/PF5: J4.20; also elsewhere on the board
/DB25/PF6: J4.19; also elsewhere on the board
/DB25/PF7: J4.18; also elsewhere on the board
GND: J4.0 (PAD), J4.25; also elsewhere on the board

Notes on the sheet:
PD2 (D0/RX)
PD0 (D3/SCL)
PD4 (D4/A6)
PF6 (D19/A1)
PF4 (D21/A3)
PC6 (D5)
PB4 (D8/A8)
PB1 (D15)
PE6 (D7)
PB5 (D9/A9)
PD1 (D2/SDA)
PD3 (D1/TX)
PB3 (D14)
PF7 (D18/A0)
PB2 (D16)
PD7 (D6/A7)
PB6 (D10/A10)
PF5 (D20/A2)

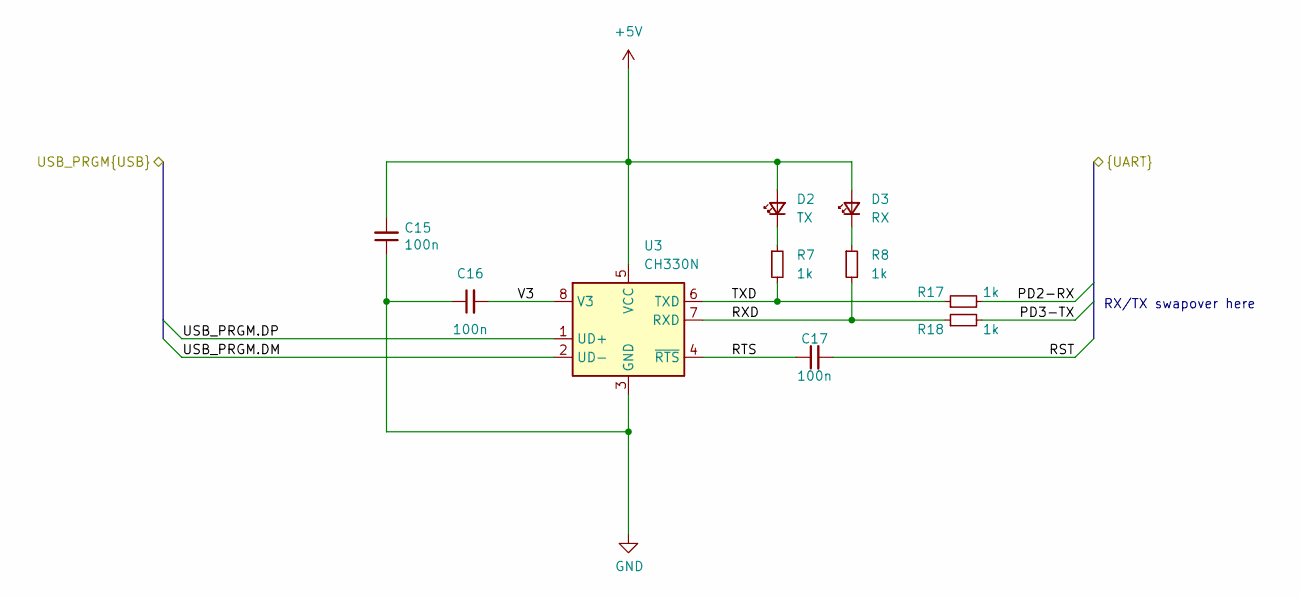
[picture p37: schematic UART.kicad_sch, OpenRetroPad]

Parts:
C15, C16, C17: 100n; C_0603_1608Metric
D2: TX; LED_0603_1608Metric
D3: RX; LED_0603_1608Metric
R7, R8, R17, R18: 1k; R_0603_1608Metric
U3: CH330N; SOIC-8_3.9x4.9mm_P1.27mm

Connections:
+5V: C15.2, D2.2 (A), D3.2 (A), U3.5 (VCC); also elsewhere on the board
/DB25/PD2-RX: R17.2; also elsewhere on the board
/DB25/PD3-TX: R18.2; also elsewhere on the board
/DB25/RST: C17.2; also elsewhere on the board
/UART/RTS: C17.1, U3.4 (~RTS)
/UART/RXD: R8.2, R18.1, U3.7 (RXD)
/UART/TXD: R7.2, R17.1, U3.6 (TXD)
/UART/USB_PRGM.DM: U3.2 (UD-); also elsewhere on the board
/UART/USB_PRGM.DP: U3.1 (UD+); also elsewhere on the board
/UART/V3: C16.2, U3.8 (V3)
GND: C15.1, C16.1, U3.3 (GND); also elsewhere on the board
unnamed: D2.1 (K), R7.1
unnamed: D3.1 (K), R8.1

Notes on the sheet:
RX/TX swapover here

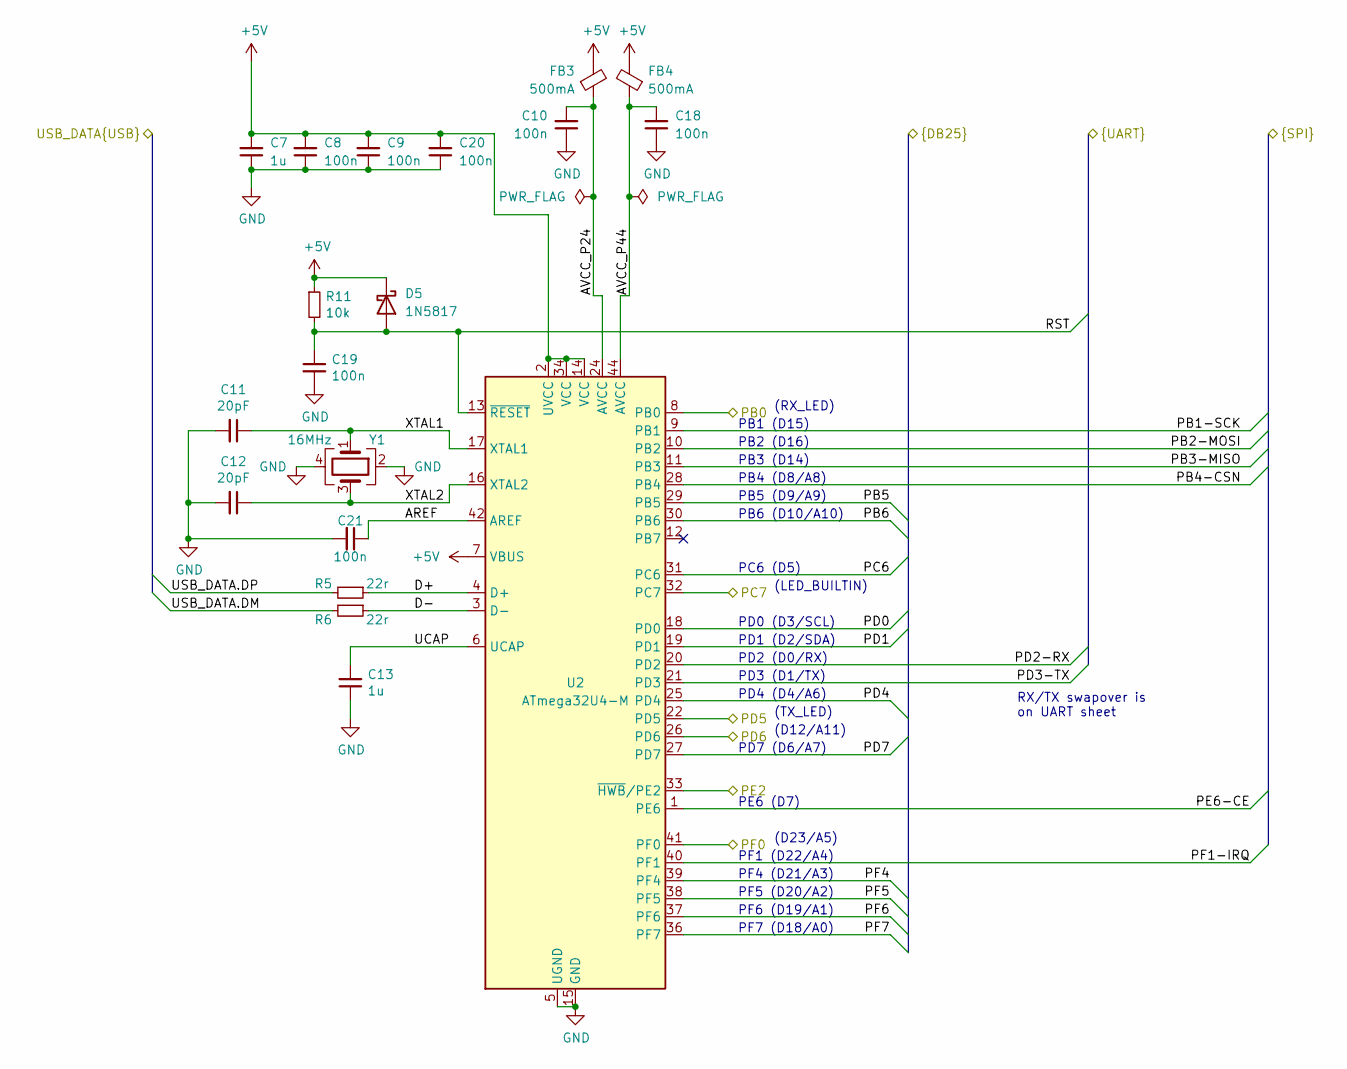
[picture p38: schematic ATMega32U4-M.kicad_sch, OpenRetroPad]

Parts:
C7, C13: 1u; C_0603_1608Metric
C8, C9, C10, C18, C19, C20, C21: 100n; C_0603_1608Metric
C11, C12: 20pF; C_0603_1608Metric
D5: 1N5817; D_SOD-323
FB3, FB4: 500mA; L_0603_1608Metric
R5, R6: 22r; R_0603_1608Metric
R11: 10k; R_0603_1608Metric
U2: ATmega32U4-M; TQFP-44_10x10mm_P0.8mm
Y1: 16MHz; Crystal_SMD_3225-4Pin_3.2x2.5mm

Connections:
+5V: C7.2, C8.2, C9.2, C20.2, D5.1 (K), FB3.2, FB4.2, R11.1, U2.2 (UVCC), U2.7 (VBUS), U2.14 (VCC), U2.34 (VCC); also elsewhere on the board
/DB25/PB1-SCK: U2.9 (PB1); also elsewhere on the board
/DB25/PB2-MOSI: U2.10 (PB2); also elsewhere on the board
/DB25/PB3-MISO: U2.11 (PB3); also elsewhere on the board
/DB25/PB4-CSN: U2.28 (PB4); also elsewhere on the board
/DB25/PB5: U2.29 (PB5); also elsewhere on the board
/DB25/PB6: U2.30 (PB6); also elsewhere on the board
/DB25/PC6: U2.31 (PC6); also elsewhere on the board
/DB25/PD0: U2.18 (PD0); also elsewhere on the board
/DB25/PD1: U2.19 (PD1); also elsewhere on the board
/DB25/PD2-RX: U2.20 (PD2); also elsewhere on the board
/DB25/PD3-TX: U2.21 (PD3); also elsewhere on the board
/DB25/PD4: U2.25 (PD4); also elsewhere on the board
/DB25/PD7: U2.27 (PD7); also elsewhere on the board
/DB25/PE6-CE: U2.1 (PE6); also elsewhere on the board
/DB25/PF1-IRQ: U2.40 (PF1); also elsewhere on the board
/DB25/PF4: U2.39 (PF4); also elsewhere on the board
/DB25/PF5: U2.38 (PF5); also elsewhere on the board
/DB25/PF6: U2.37 (PF6); also elsewhere on the board
/DB25/PF7: U2.36 (PF7); also elsewhere on the board
/DB25/RST: C19.1, D5.2 (A), R11.2, U2.13 (~RESET); also elsewhere on the board
/Microcontroller/AREF: C21.1, U2.42 (AREF)
/Microcontroller/AVCC_P24: C10.2, FB3.1, U2.24 (AVCC)
/Microcontroller/AVCC_P44: C18.2, FB4.1, U2.44 (AVCC)
/Microcontroller/D+: R5.1, U2.4 (D+)
/Microcontroller/D-: R6.1, U2.3 (D-)
/Microcontroller/UCAP: C13.2, U2.6 (UCAP)
/Microcontroller/USB_DATA.DM: R6.2; also elsewhere on the board
/Microcontroller/USB_DATA.DP: R5.2; also elsewhere on the board
/Microcontroller/XTAL1: C11.1, U2.17 (XTAL1), Y1.1
/Microcontroller/XTAL2: C12.1, U2.16 (XTAL2), Y1.3
/PB0-RX_LED: U2.8 (PB0); also elsewhere on the board
/PC7-LED_USER: U2.32 (PC7); also elsewhere on the board
/PD5-TX_LED: U2.22 (PD5); also elsewhere on the board
/PD6-CC2: U2.26 (PD6); also elsewhere on the board
/PE2-HWB: U2.33 (~HWB/PE2); also elsewhere on the board
/PF0-CC1: U2.41 (PF0); also elsewhere on the board
GND: C7.1, C8.1, C9.1, C10.1, C11.2, C12.2, C13.1, C18.1, C19.2, C20.1, C21.2, U2.5 (UGND), U2.15 (GND), U2.23 (GND), U2.35 (GND), U2.43 (GND), Y1.2, Y1.4; also elsewhere on the board

Notes on the sheet:
PD4 (D4/A6)
PD3 (D1/TX)
PD0 (D3/SCL)
(D23/A5)
PB6 (D10/A10)
PD1 (D2/SDA)
(D12/A11)
PB1 (D15)
RX/TX swapover is on UART sheet
PB3 (D14)
(LED_BUILTIN)
PF1 (D22/A4)
PB2 (D16)
PE6 (D7)
PD7 (D6/A7)
(RX_LED)
PF6 (D19/A1)
PF5 (D20/A2)
PF4 (D21/A3)
PB4 (D8/A8)
PB5 (D9/A9)
PC6 (D5)
PF7 (D18/A0)
PD2 (D0/RX)
(TX_LED)

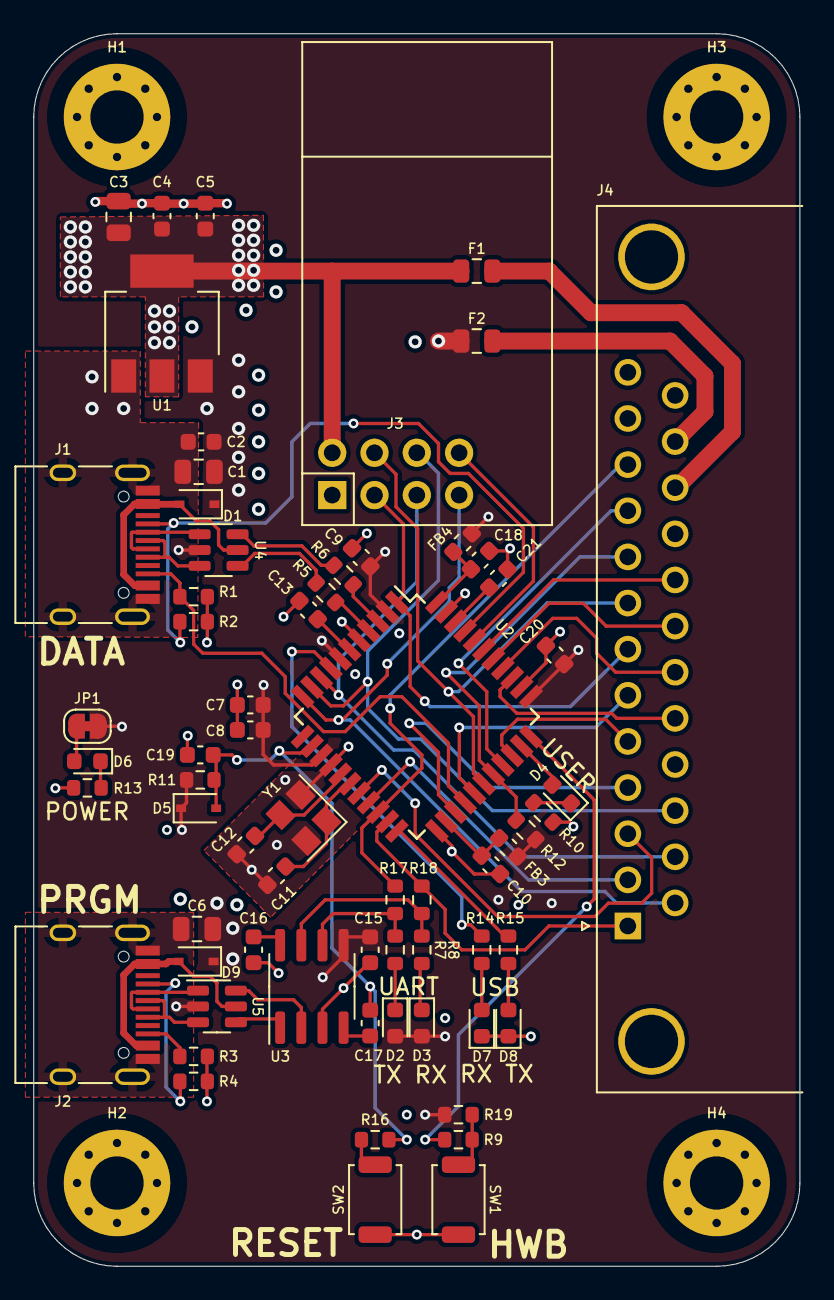
[picture p39: board OpenRetroPad.kicad_pcb from above]

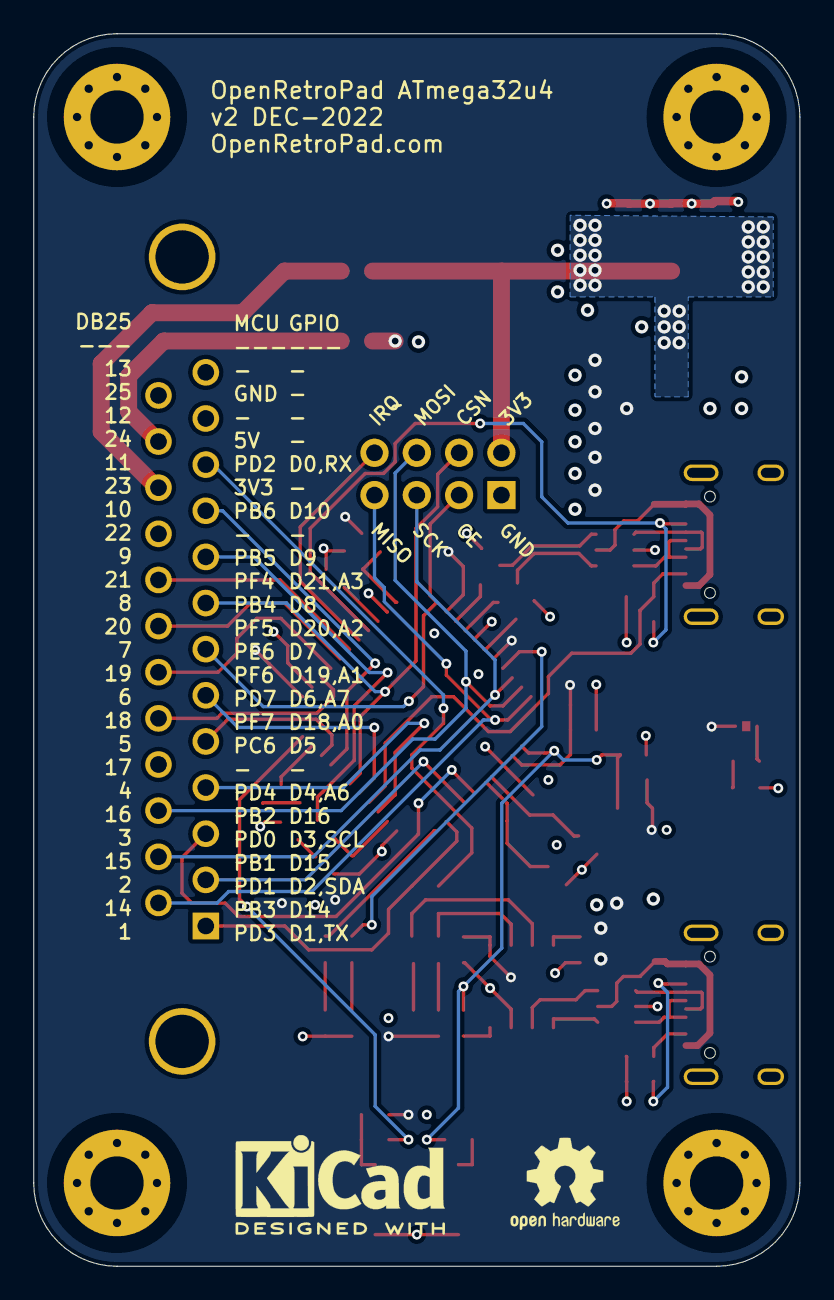
[picture p40: board OpenRetroPad.kicad_pcb from below]

Board: 4 copper layers, 46.0 x 74.0 mm, 71 parts (2 on the bottom side), 64 nets.

Other parts of the board:
C6: 10u; C_0805_2012Metric
D9: D_Schottky; D_SOD-323
J2: USB_C_Receptacle_USB2.0; USB_C_Receptacle_HRO_TYPE-C-31-M-12
R3, R4: 5.1k; R_0603_1608Metric
U5: USBLC6-2SC6; SOT-23-6

Their connections:
+5V: C6.2, D9.1 (K); also elsewhere on the board
/UART/USB_PRGM.DM: U5.6 (I/O1); also elsewhere on the board
/UART/USB_PRGM.DP: U5.4 (I/O2); also elsewhere on the board
/USB Program/CC1: J2.A5 (CC1), R4.2
/USB Program/CC2: J2.B5 (CC2), R3.1
/USB Program/D+: J2.A6 (D+), J2.B6 (D+), U5.3 (I/O2)
/USB Program/D-: J2.A7 (D-), J2.B7 (D-), U5.1 (I/O1)
/USB Program/VBUS: D9.2 (A), J2.A4 (VBUS), J2.A9 (VBUS), J2.B4 (VBUS), J2.B9 (VBUS), U5.5 (VBUS)
GND: C6.1, J2.A1 (GND), J2.A12 (GND), J2.B1 (GND), J2.B12 (GND), J2.S1 (SHIELD), R3.2, R4.1, U5.2 (GND); also elsewhere on the board
