OpenRetroPad/OpenRetroPadHW/(commit log)

2021-01-03 Initial ATmega32u4 hardware files
    [1050170001.stp, BOM.csv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]
2021-01-03 Update layout around MicroUSB connector, add teardrops
    [OpenRetroPad-B_Cu.gbr, OpenRetroPad-B_Mask.gbr, OpenRetroPad-B_Paste.gbr, OpenRetroPad-B_SilkS.gbr, OpenRetroPad-Edge_Cuts.gbr, OpenRetroPad-F_Cu.gbr, OpenRetroPad-F_Mask.gbr, OpenRetroPad-F_Paste.gbr]
2021-01-03 Update text on back to include domain name instead of github link
    [OpenRetroPad-B_Cu.gbr, OpenRetroPad-B_Mask.gbr, OpenRetroPad-B_Paste.gbr, OpenRetroPad-B_SilkS.gbr, OpenRetroPad-Edge_Cuts.gbr, OpenRetroPad-F_Cu.gbr, OpenRetroPad-F_Mask.gbr, OpenRetroPad-F_Paste.gbr]
2021-01-06 Convert from 4 layer to 2 layer board
    [OpenRetroPad.kicad_pcb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]
2021-01-06 Update outputs for 2 layer board
    [OpenRetroPad-B_Cu.gbr, OpenRetroPad-B_Mask.gbr, OpenRetroPad-B_Paste.gbr, OpenRetroPad-B_SilkS.gbr, OpenRetroPad-Edge_Cuts.gbr, OpenRetroPad-F_Cu.gbr, OpenRetroPad-F_Mask.gbr, OpenRetroPad-F_Paste.gbr]
2021-01-24 Update 2 layer board and use 0805 components, include outputs
    [BOM.csv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]
2021-05-12 - Add on-board programmer - Micro USB -> USB-C
    [1050170001.stp, HRO TYPE-C-31-M-12.step, OpenRetroPad-bom.csv, OpenRetroPad.kicad_pcb, OpenRetroPad.sch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]
2022-12-11 Update V2
    [ATMega32U4-M.kicad_sch, BOM-OpenRetroPad.csv, DB25.kicad_sch, HRO TYPE-C-31-M-12.step, IO.kicad_sch, NRF24.kicad_sch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]
2022-12-11 Update layout/assembly pdf
    [OpenRetroPad-CuBottom.gbr, OpenRetroPad-CuIn1.gbr, OpenRetroPad-CuIn2.gbr, OpenRetroPad-CuTop.gbr, OpenRetroPad-EdgeCuts.gbr, OpenRetroPad-MaskBottom.gbr, OpenRetroPad-MaskTop.gbr, OpenRetroPad-NPTH.drl]
2022-12-20 Review and updates to power path
    [ATMega32U4-M.kicad_sch, BOM-OpenRetroPad.csv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]
2022-12-29 Schematic, routing and layout changes post review.
    [ATMega32U4-M.kicad_sch, BOM-OpenRetroPad.csv, DB25.kicad_sch, IO.kicad_sch, NRF24.kicad_sch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]
2022-12-29 Update notes, add io for reading cc pins, minor changes to schematic and routing.
    [ATMega32U4-M.kicad_sch, DB25.kicad_sch, IO.kicad_sch, NRF24.kicad_sch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]
2023-01-05 Add pngs for schematic and assembly from pdfs
2023-01-09 Adjust copper pours on top/bottom layers, update assembly pdf to include inner layers
    [OpenRetroPad-CuBottom.gbr, OpenRetroPad-CuIn1.gbr, OpenRetroPad-CuIn2.gbr, OpenRetroPad-CuTop.gbr, OpenRetroPad-EdgeCuts.gbr, OpenRetroPad-MaskBottom.gbr, OpenRetroPad-MaskTop.gbr, OpenRetroPad-NPTH.drl]
2023-01-09 Change CC pin <-> ADC pin, adjust routing
    [ATMega32U4-M.kicad_sch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]
2023-01-09 Include measurements on assembly pdf
